John-WL/Hydra-Alpha/prog/documentation/interrupts on Esp32.png

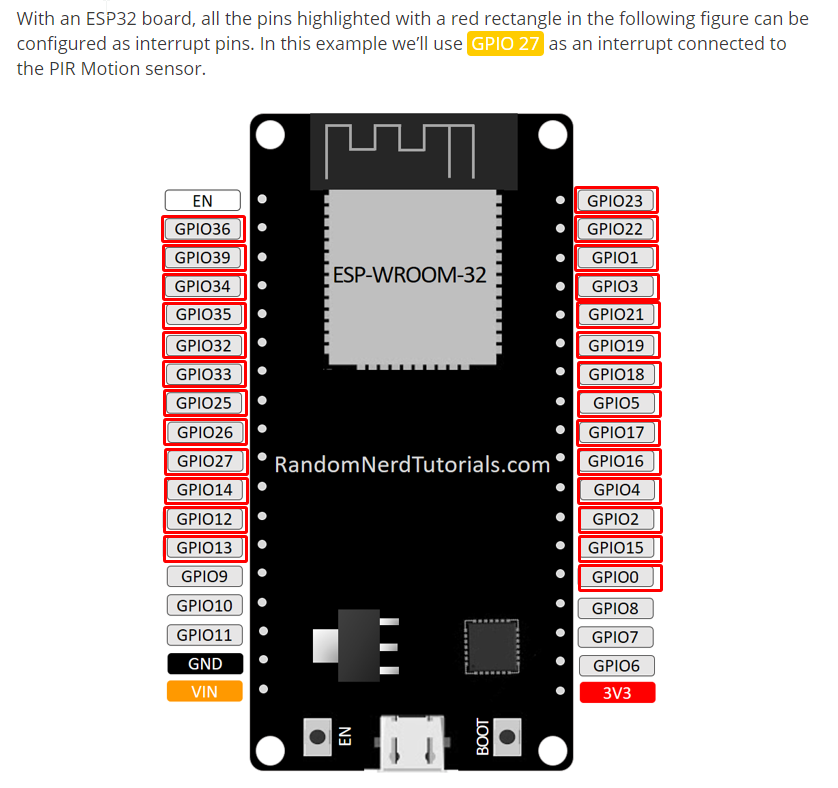
prog/documentation/interrupts on Esp32.png
