John-WL/Hydra-Alpha/board/altium/altium_alpha/Folder Structure - 2021-04-07 11-21-35/BOM/Bill of Materials-PCB_Hydra.xlsx

Comment | Description | Designator | Footprint | LibRef | Quantity
12063C104MAT2A | Capacitor | C1_1, C1_3, C1_4, C2_1, C3_13, C3_15, C4_3, C4_4, C4_7, C4_8, C4_10, C4_11, C4_13 | C1206 | Cap | 13
C1206C103M5RACTU | Capacitor | C1_2, C4_1, C4_2, C4_14, C4_15 | C1206 | Cap | 5
EMK316BJ106MLHT | Capacitor | C1_5, C3_14 | C1206 | Cap | 2
CML1206C0G470JT50V | Capacitor | C1_6, C1_7 | C1206 | Cap | 2
CL31A226KOHNNNE | Capacitor | C1_8, C3_1, C3_2, C3_3 | C1206 | Cap | 4
EMHS250GRA102MKE0S | Capacitor | C2_2, C2_3, C2_4 | CAP-ELECTRO-KE0 | Cap | 3
CML1206X7R472KT50V | Capacitor | C3_4, C3_5, C3_6 | C1206 | Cap | 3
885012208085 | Capacitor | C3_7, C3_8, C3_9 | C1206 | Cap | 3
CM316X5R475K25AT | Capacitor | C3_10, C3_11, C3_18, C3_19 | C1206 | Cap | 4
885382208005 | Capacitor | C3_12, C3_16 | C1206 | Cap | 2
EMK316BBJ476ML-T | Capacitor | C3_17 | C1206 | Cap | 1
C1206C474M5RECAUTO | Capacitor | C4_5 | C1206 | Cap | 1
107AXZ016MQ5 | Capacitor | C4_9, C4_12 | CAP-ELECTRO-530530 | Cap | 2
LTST-C230KRKT | Typical INFRARED GaAs LED | D1_1, D1_2 | C1206-POLARIZED | LED0 | 2
APT3216QBC/D | Typical INFRARED GaAs LED | D1_3, D4_1, D4_2, D4_3, D4_4 | C1206-POLARIZED | LED0 | 5
CZRF52C3V3 | Zener Diode | D3_1, D3_3 | C1206-POLARIZED | D Zener | 2
ACDBN160-HF | Default Diode | D3_4, D3_5 | C1206-POLARIZED | Diode | 2
APT3216SGC | Typical INFRARED GaAs LED | D3_6, D3_7, D3_8 | C1206-POLARIZED | LED0 | 3
MPXV1D0830L3R3 | Inductor | L3_1, L3_2, L3_3 | mpxv1D0830 | Inductor | 3
Mounting Hole | Generic Antenna | M3_1, M3_2, M3_3, M3_4, M3_5 | MOUNTING-HOLE-M3 | Antenna | 5
USB3085-30-A |  | P1_1 | USB-MICRO-CONNECTOR | Usb Connector | 1
Nrf24L01 | Header, 4-Pin, Dual row | P1_2 | HDR2X4-42 | Header 4X2 | 1
EspCam | Header, 4-Pin | P1_3 | HDR1X4-42 | Header 4 | 1
Sonar | Header, 4-Pin | P1_4 | HDR1X4-42 | Header 4 | 1
Header 3 | Header, 3-Pin | P2_1, P2_2, P2_3, P2_4, P2_5, P2_6, P2_7, P2_8, P2_9, P2_10, P2_11, P2_12 | HDR1X3-42 | Header 3 | 12
Bno055 port | Header, 8-Pin | P2_13 | HDR1X8-42 | Header 8 | 1
1521860000 | Header, 2-Pin | P3_1 | HDR1X2-508-POLARIZED | Header 2 | 1
Right Motor Connector | Header, 2-Pin | P4_1 | HDR1X2-42 | Header 2 | 1
Left Motor Connector | Header, 2-Pin | P4_2 | HDR1X2-42 | Header 2 | 1
T2N7002AK,LM | N-Channel MOSFET | Q1_1, Q1_2, Q2_1, Q2_2, Q3_2 | SOT23_L | MOSFET-N | 5
RQ5L015SPTL | P-Channel MOSFET | Q3_1 | SOT23_L | MOSFET-P | 1
Res1 | Resistor | R1_1, R1_2, R1_3, R1_4, R1_5, R1_6, R1_7, R1_8, R1_9, R1_10, R1_11, R1_12, R1_13, R1_14, R2_1, R2_2, R2_3, R2_4, R3_1, R3_2, R3_3, R3_4, R3_5, R3_6, R3_7, R3_8, R3_9, R3_10, R3_11, R3_13, R3_14, R3_15, R3_16, R3_18, R3_19, R3_20, R3_21, R3_22, R3_23, R3_24, R4_1, R4_2, R4_4, R4_5, R4_8, R4_9, R4_10, R4_11, R4_13, R4_14, R4_15 | C1206 | Res1 | 51
ST4ETA103 | Potentiometer | R3_25, R3_26, R3_27 | ST-4ETA103 | RPot | 3
ST32ETB203 | Potentiometer | R4_3 | ST-32EB | RPot | 1
PCS2512DR1000ET | Resistor | R4_6, R4_7 | 2512 | Res1 | 2
Res1 | Resistor | R4_12 | C0805 | Res1 | 1
FSM4LPASTR | Switch | S1_1, S1_2 | SW4-SMT | SW-PB | 2
S1A | Single-Pole, Single-Throw Switch | S3_1 | SW2-THR | SW-SPST | 1
Mounting Hole | Generic Antenna | T1_1, T1_2, T1_3, T1_4, T1_5, T1_6, T3_1, T3_2, T3_3, T3_4, T3_5, T3_6, T3_7, T3_8, T3_9, T3_10, T3_11, T3_12 | TESTPOINT | Antenna | 18
ESP32-WROOM-32__16MB_ | Integrated Circuit | U1_1 | ESP32WROOM32D16MB | ESP32-WROOM-32__16MB_ | 1
FT232RL |  | U1_2 | SOP65P778X200-28N | Ft232 | 1
Pca9685 | Serial pwm led driver | U2_1 | SOP65P640X110-28N | Pca9685 | 1
Xr77103-A1r0 | Dc to dc step down converter | U3_1 | 32-TQFN (4x4) | Xr77103-A1r0 | 1
Mic37252 |  | U3_2 | TO-263 (5) | Mic37252 | 1
TS391SN2T1G |  | U3_3 | TSOP5(6) | Op Amp | 1
Drv8829 |  | U4_1, U4_2 | SOP65P640X120-28N-GROUND_SINK | Drv8829 | 2
Xra1201 |  | U4_3 | SOP65P640X110-24N | Xra1201 | 1
