John-WL/Hydra-Alpha/board/altium/altium_alpha/Project Outputs for PCB_Hydra/BOM/generated from digikey.xlsx

Index | Quantity | Part Number | Manufacturer Part Number | Description | Customer Reference | Available | Backorder | Unit Price | Extended Price CAD
1 | 13 | 478-12813-1-ND | 12063C104MAT2A | CAP CER 0.1UF 25V X7R 1206 |  | 13 | 0 | 0.235 | 3.06
2 | 5 | 399-8138-1-ND | C1206C103M5RACTU | CAP CER 10000PF 50V X7R 1206 |  | 5 | 0 | 0.23 | 1.15
3 | 2 | 587-4882-1-ND | EMK316BJ106MLHT | CAP CER 10UF 16V X5R 1206 |  | 2 | 0 | 0.48 | 0.96
4 | 2 | 738-CML1206C0G470JT50VCT-ND | CML1206C0G470JT50V | CAP CER 47PF 50V C0G/NP0 1206 |  | 2 | 0 | 0.26 | 0.52
5 | 4 | 1276-3048-1-ND | CL31A226KOHNNNE | CAP CER 22UF 16V X5R 1206 |  | 4 | 0 | 0.55 | 2.20
6 | 3 | 565-5087-1-ND | EMHS250GRA102MKE0S | CAP ALUM 1000UF 20% 25V SMD |  | 3 | 0 | 2.03 | 6.09
7 | 3 | 738-CML1206X7R472KT50VCT-ND | CML1206X7R472KT50V | CAP CER 4700PF 50V X7R 1206 |  | 3 | 0 | 0.27 | 0.81
8 | 3 | 732-8125-1-ND | 885012208085 | CAP CER 0.047UF 50V X7R 1206 |  | 3 | 0 | 0.18 | 0.54
9 | 4 | 1253-2080-1-ND | CM316X5R475K25AT | CAP CER 4.7UF 25V X5R 1206 |  | 4 | 0 | 0.49 | 1.96
10 | 2 | 732-13203-1-ND | 885382208005 | CAP CER 1UF 50V X7R 1206 |  | 2 | 0 | 0.37 | 0.74
11 | 1 | 587-5425-1-ND | EMK316BBJ476ML-T | CAP CER 47UF 16V X5R 1206 |  | 1 | 0 | 1 | 1.00
12 | 1 | 399-C1206C474M5RECAUTOCT-ND | C1206C474M5RECAUTO | CAP CER 1206 470NF 50V X7R 20% |  | 1 | 0 | 0.55 | 0.55
13 | 2 | 1572-1239-1-ND | 107AXZ016MQ5 | CAP ALUM 100UF 20% 16V SMD |  | 2 | 0 | 0.64 | 1.28
14 | 2 | 160-1457-1-ND | LTST-C230KRKT | LED RED CLEAR CHIP SMD |  | 2 | 0 | 0.42 | 0.84
15 | 5 | 754-1439-1-ND | APT3216QBC/D | LED BLUE CLEAR CHIP SMD |  | 5 | 0 | 0.66 | 3.30
16 | 2 | 641-1056-1-ND | CZRF52C3V3 | DIODE ZENER 3.3V 200MW 1005 |  | 2 | 0 | 0.56 | 1.12
17 | 2 | 641-1616-1-ND | ACDBN160-HF | DIODE SCHOTTKY 60V 1A 1206 |  | 2 | 0 | 0.53 | 1.06
18 | 3 | 754-1141-1-ND | APT3216SGC | LED GREEN CLEAR CHIP SMD |  | 3 | 0 | 0.42 | 1.26
19 | 3 | 399-MPXV1D0830L3R3CT-ND | MPXV1D0830L3R3 | FIXED IND 3.3UH 8.9A 22.3 MOHM |  | 3 | 0 | 3.22 | 9.66
20 | 1 | 2073-USB3085-30-ACT-ND | USB3085-30-A | MICRO A/B SKT, BOTTOM-SMT, R/A, |  | 1 | 0 | 0.91 | 0.91
21 | 5 | T2N7002AKLMCT-ND | T2N7002AK,LM | MOSFET N-CH 60V 200MA SOT23 |  | 5 | 0 | 0.22 | 1.10
22 | 1 | RQ5L015SPTLCT-ND | RQ5L015SPTL | MOSFET P-CH 60V 1.5A TSMT3 |  | 1 | 0 | 0.6 | 0.60
23 | 3 | ST4ETA103CT-ND | ST4ETA103 | TRIMMER 10K OHM 0.25W J LEAD TOP |  | 3 | 0 | 1.74 | 5.22
24 | 1 | ST32ETB203CT-ND | ST32ETB203 | TRIMMER 20K OHM 0.125W GW TOP |  | 1 | 0 | 1.89 | 1.89
25 | 2 | 450-2139-1-ND | FSM4LPASTR | SWITCH TACTILE SPST-NO 0.05A 24V |  | 2 | 0 | 0.74 | 1.48
26 | 1 | 360-2893-ND | S1A | SWITCH TOGGLE SPST 15A 125V |  | 1 | 0 | 8.51 | 8.51
27 | 1 | 1904-1028-1-ND | ESP32-WROOM-32U (16MB) | RX TXRX MODULE WIFI U.FL SMD |  | 1 | 0 | 6.76 | 6.76
28 | 1 | 768-1007-1-ND | FT232RL-REEL | IC USB FS SERIAL UART 28-SSOP |  | 1 | 0 | 6.69 | 6.69
29 | 1 | 568-8366-5-ND | PCA9685PW,112 | IC LED DRVR LIN DIM 25MA 28TSSOP |  | 1 | 0 | 3.81 | 3.81
30 | 1 | 1016-2216-1-ND | XR77103ELBTR-A1R0 | IC REG BUCK ADJ/FIX TRPL 32TQFN |  | 1 | 0 | 5.21 | 5.21
31 | 1 | 576-1764-5-ND | MIC37252WU | IC REG LIN POS ADJ 2.5A TO263-5 |  | 1 | 0 | 3.61 | 3.61
32 | 1 | TS391SN2T1GOSCT-ND | TS391SN2T1G | IC COMPARATOR LOW PWR 5-TSOP |  | 1 | 0 | 0.9 | 0.90
33 | 2 | 296-28829-1-ND | DRV8829PWPR | IC MTR DRVR BIPLR 8.2-45V 28SSOP |  | 2 | 0 | 5.92 | 11.84
