John-WL/Hydra-Alpha/board/altium/altium_alpha/downloaded libs/drv8829/LIB_DRV8829PWP/DRV8829PWP/3D/DRV8829PWP.stp

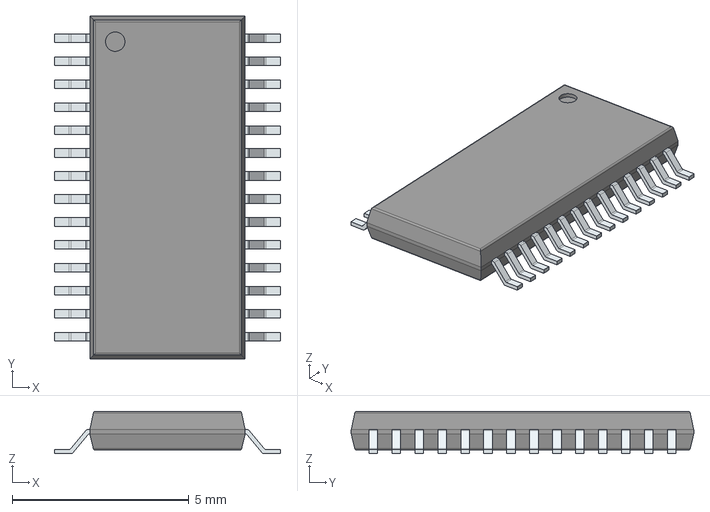
[picture p10: CAD file, 2021-04-13]
board/altium/altium_alpha/downloaded libs/drv8829/LIB_DRV8829PWP/DRV8829PWP/3D/DRV8829PWP.stp
6.40 x 9.70 x 1.20 mm
PinsArrayLR
