John-WL/Hydra-Alpha/board/altium/altium_alpha/downloaded libs/esp32/LIB_ESP32-WROOM-32__16MB_/ESP32-WROOM-32__16MB_/3D/ESP32-WROOM-32__16MB_.stp

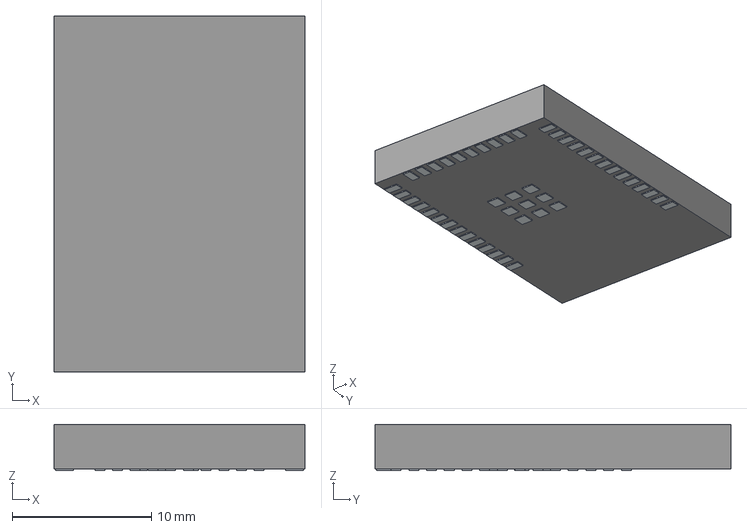
[picture p11: CAD file, 2021-04-13]
board/altium/altium_alpha/downloaded libs/esp32/LIB_ESP32-WROOM-32__16MB_/ESP32-WROOM-32__16MB_/3D/ESP32-WROOM-32__16MB_.stp
18.0 x 25.5 x 3.30 mm
Pins
