John-WL/Hydra-Alpha/board/altium/altium_alpha/downloaded libs/ft232r/LIB_FT232RL/FT232RL/3D/FT232RL.stp

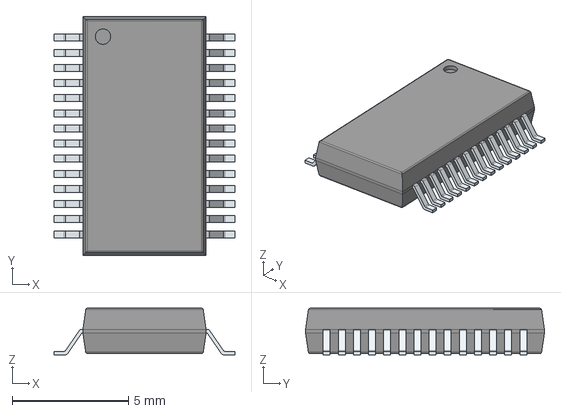
[picture p12: CAD file, 2021-04-13]
board/altium/altium_alpha/downloaded libs/ft232r/LIB_FT232RL/FT232RL/3D/FT232RL.stp
7.78 x 10.3 x 2.00 mm
PinsArrayLR
