John-WL/Hydra-Alpha/board/altium/altium_alpha/downloaded libs/pca9685/LIB_PCA9685PW,112/PCA9685PW,112/3D/PCA9685PW,112.stp

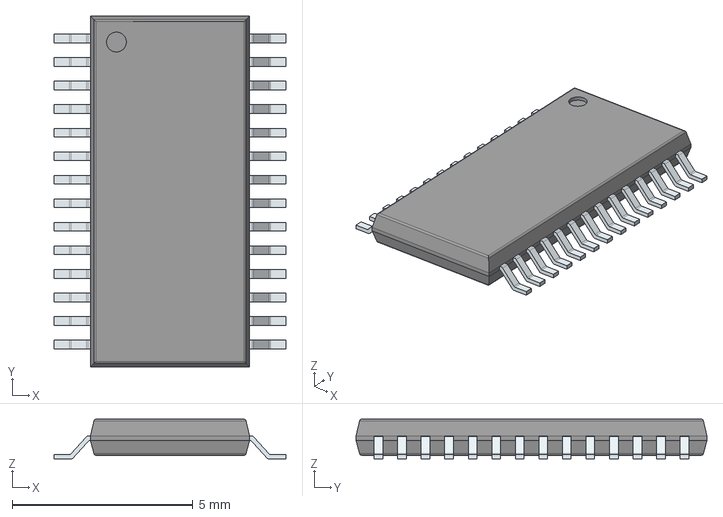
[picture p13: CAD file, 2021-04-13]
board/altium/altium_alpha/downloaded libs/pca9685/LIB_PCA9685PW,112/PCA9685PW,112/3D/PCA9685PW,112.stp
6.40 x 9.70 x 1.10 mm
PinsArrayLR
