John-WL/Hydra-Alpha/board/altium/altium_alpha/downloaded libs/xra1201/LIB_PCA9539PW,118/PCA9539PW,118/3D/PCA9539PW,118.stp

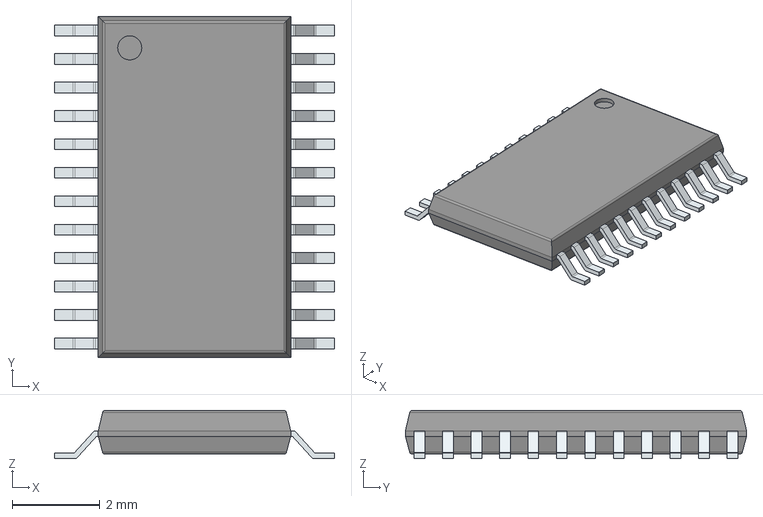
[picture p14: CAD file, 2021-04-13]
board/altium/altium_alpha/downloaded libs/xra1201/LIB_PCA9539PW,118/PCA9539PW,118/3D/PCA9539PW,118.stp
6.40 x 7.80 x 1.10 mm
PinsArrayLR
