John-WL/Hydra-Alpha/board/altium/altium_alpha/Folder Structure - 2021-04-07 11-21-35/ExportSTEP/PCB_Alpha.step

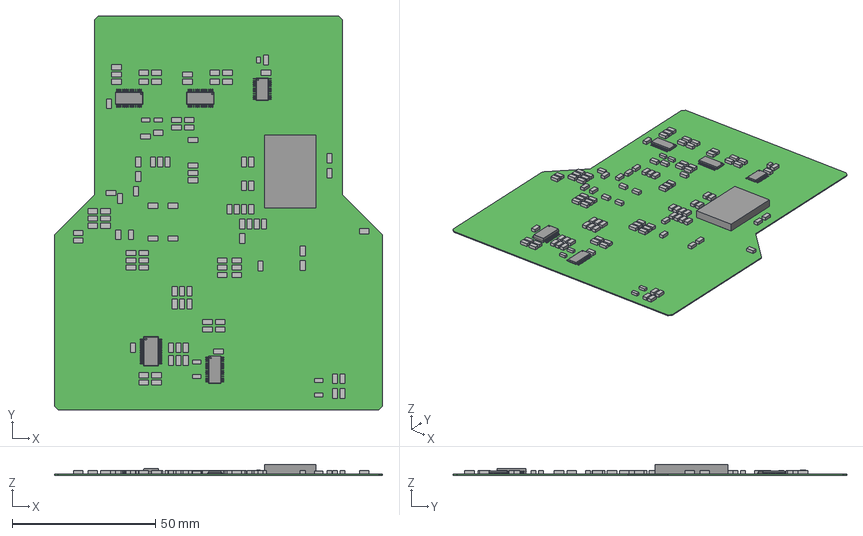
[picture p15: CAD file, 2021-04-13]
board/altium/altium_alpha/Folder Structure - 2021-04-07 11-21-35/ExportSTEP/PCB_Alpha.step
114.3 x 137.2 x 3.71 mm
PinsArrayLR x 5
Extruded x 112
Pins
