John-WL/Hydra-Alpha/(list of files, cad)

Other CAD files:
board/altium/altium_alpha/Project Outputs for Free Documents/ExportSTEP/PCB_Alpha.step
board/altium/altium_alpha/Project Outputs for PCB_Hydra/ExportSTEP/PCB_Alpha.step
board/altium/altium_alpha/downloaded libs/drv8829/LIB_DRV8829PWP/DRV8829PWP/3D/DRV8829PWP.stl
board/altium/altium_alpha/downloaded libs/drv8829/LIB_DRV8829PWP/DRV8829PWP/Allegro/sop65p640x120-28n.psm
board/altium/altium_alpha/downloaded libs/drv8829/LIB_DRV8829PWP/DRV8829PWP/DEHDL/drv8829pwp/chips/chips.prt
board/altium/altium_alpha/downloaded libs/esp32/LIB_ESP32-WROOM-32__16MB_/ESP32-WROOM-32__16MB_/3D/ESP32-WROOM-32__16MB_.stl
board/altium/altium_alpha/downloaded libs/esp32/LIB_ESP32-WROOM-32__16MB_/ESP32-WROOM-32__16MB_/Allegro/esp32wroom3216mb.psm
board/altium/altium_alpha/downloaded libs/esp32/LIB_ESP32-WROOM-32__16MB_/ESP32-WROOM-32__16MB_/DEHDL/esp32_wroom_32__16mb_/chips/chips.prt
board/altium/altium_alpha/downloaded libs/ft232r/LIB_FT232RL/FT232RL/3D/FT232RL.stl
board/altium/altium_alpha/downloaded libs/ft232r/LIB_FT232RL/FT232RL/Allegro/sop65p778x200-28n.psm
board/altium/altium_alpha/downloaded libs/ft232r/LIB_FT232RL/FT232RL/DEHDL/ft232rl/chips/chips.prt
board/altium/altium_alpha/downloaded libs/pca9685/LIB_PCA9685PW,112/PCA9685PW,112/3D/PCA9685PW,112.stl
board/altium/altium_alpha/downloaded libs/pca9685/LIB_PCA9685PW,112/PCA9685PW,112/Allegro/sop65p640x110-28n.psm
board/altium/altium_alpha/downloaded libs/pca9685/LIB_PCA9685PW,112/PCA9685PW,112/DEHDL/pca9685pw_112/chips/chips.prt
board/altium/altium_alpha/downloaded libs/xra1201/LIB_PCA9539PW,118/PCA9539PW,118/3D/PCA9539PW,118.stl
board/altium/altium_alpha/downloaded libs/xra1201/LIB_PCA9539PW,118/PCA9539PW,118/Allegro/sop65p640x110-24n.psm
board/altium/altium_alpha/downloaded libs/xra1201/LIB_PCA9539PW,118/PCA9539PW,118/DEHDL/pca9539pw_118/chips/chips.prt
