John-WL/Hydra-Alpha/board/parts/Omnimate5.08mm Pitch.pdf

Pin headers SL 5.08/135B | Pin headers SL 5.08/180 | Pin headers SL 5.08/180B

# Omnimate Range - 5.08 mm Pitch

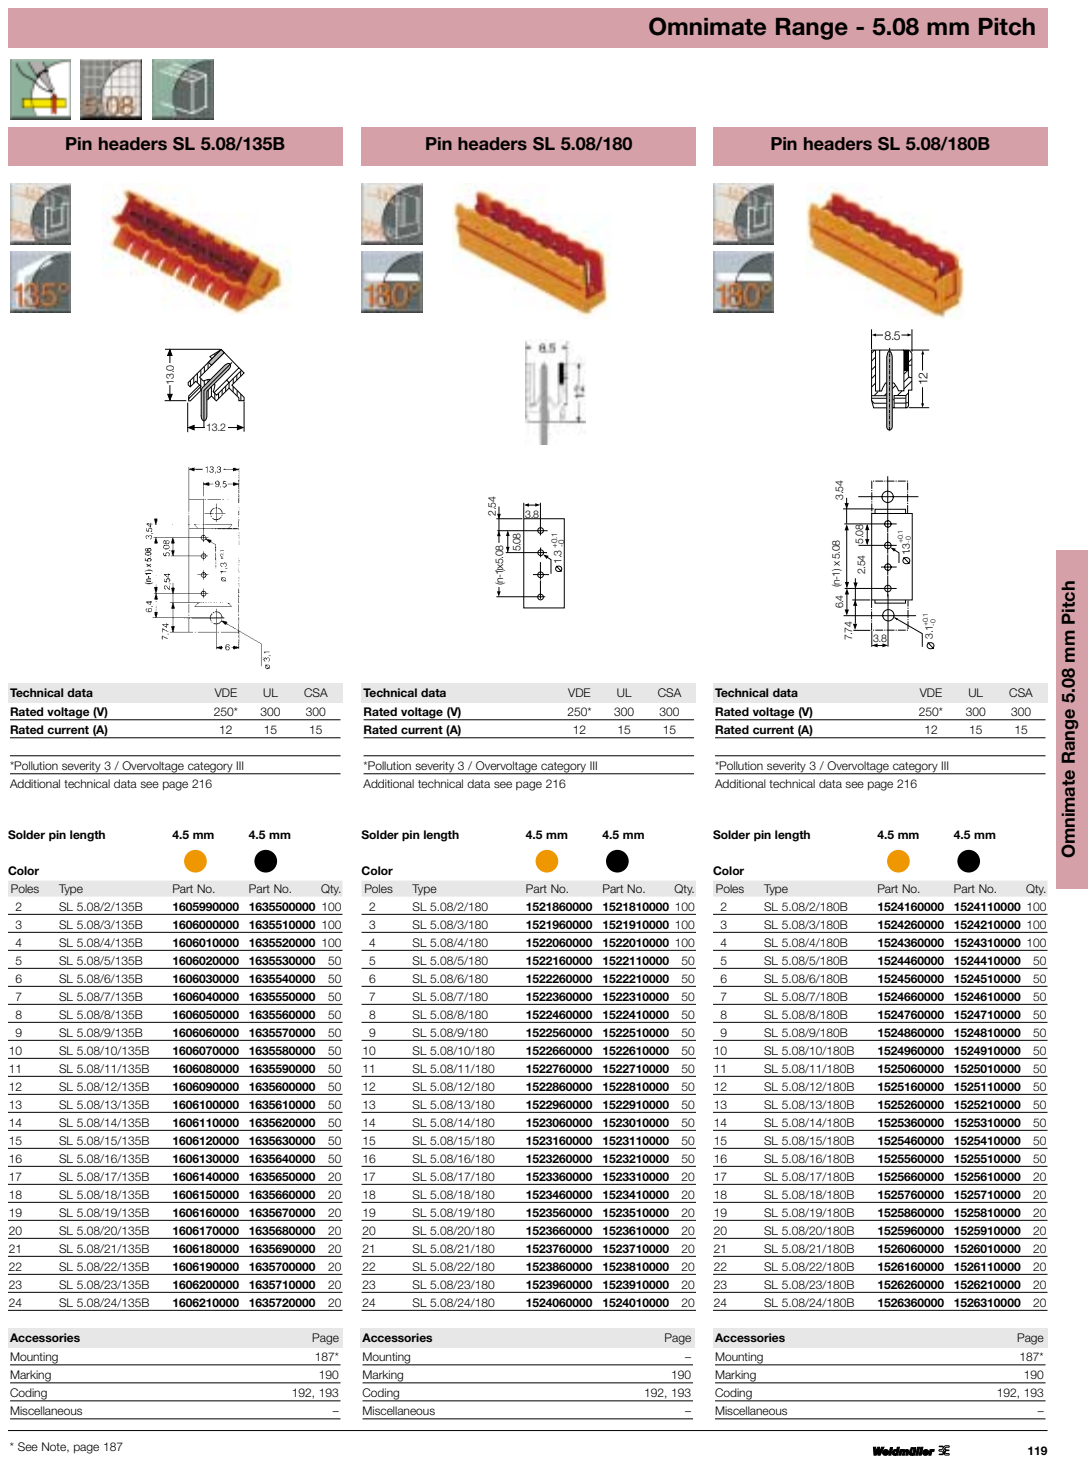
[picture p16: page 1]
Solder pin length; Color; Poles; Type; Part No.; Qty.; Technical data; VDE; CSA; Rated voltage (V); Rated current (A); Accessories; Page; Mounting; Marking; Coding; Miscellaneous

Omnimate Range 5.08 mm Pitch

*Pollution severity 3 / Overvoltage category III
Additional technical data see page 216

* See Note, page 187
