John-WL/Hydra-Alpha/board/altium/altium_alpha/PDF - 2021-04-06 14-30-56/Job1.PDF

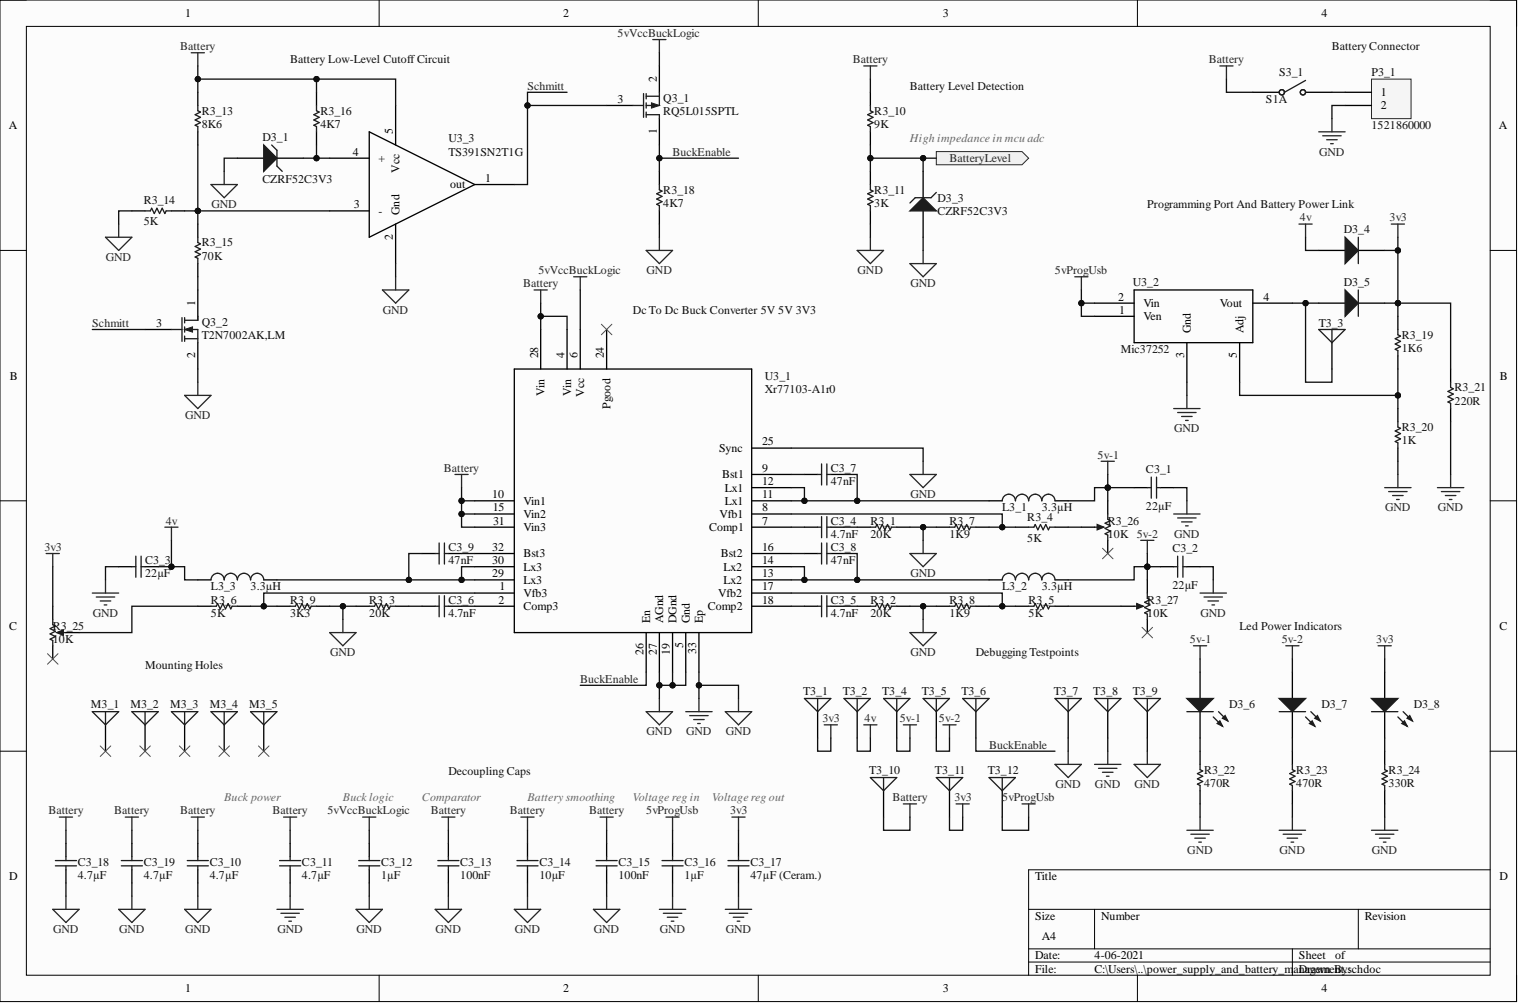
[picture p17: page 1]

Battery Low-Level Cutoff Circuit

High impedance in mcu adc

Programming Port And Battery Power Link

Dc To Dc Buck Converter 5V 5V 3V3

Vin3 31 Vin2 15 Vin1 10

Ep 33 Gnd 5 DGnd 19 AGnd 27 En 26

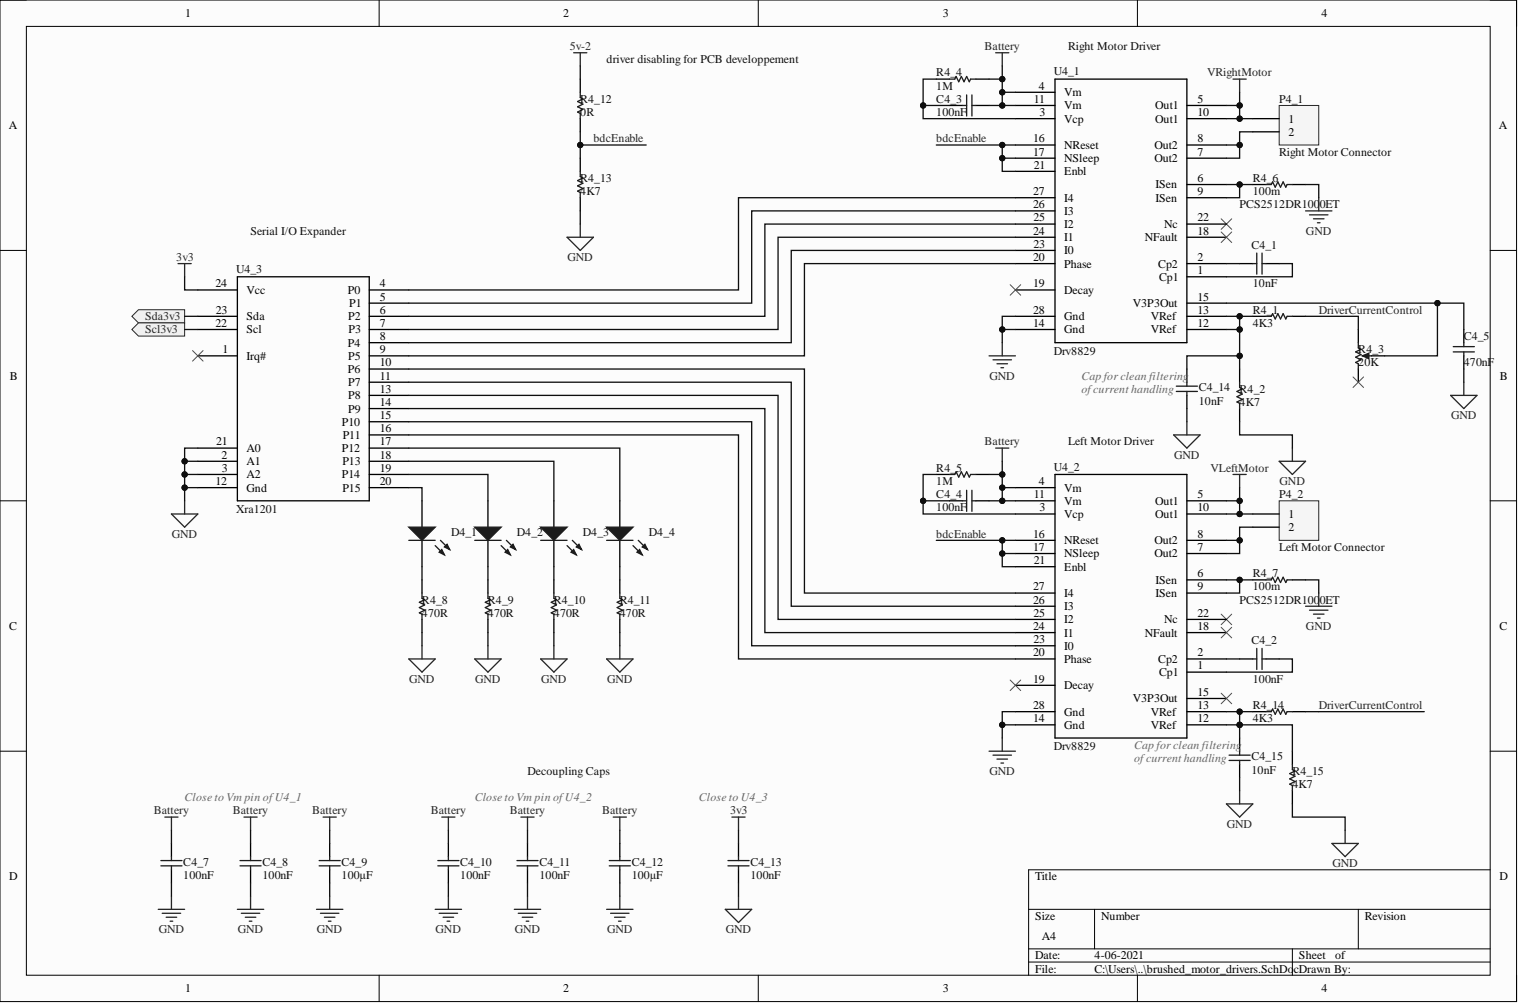
[picture p18: page 2]

driver disabling for PCB developpement

GND | Phase 20

Decay 19

Cap for clean filtering
of current handling

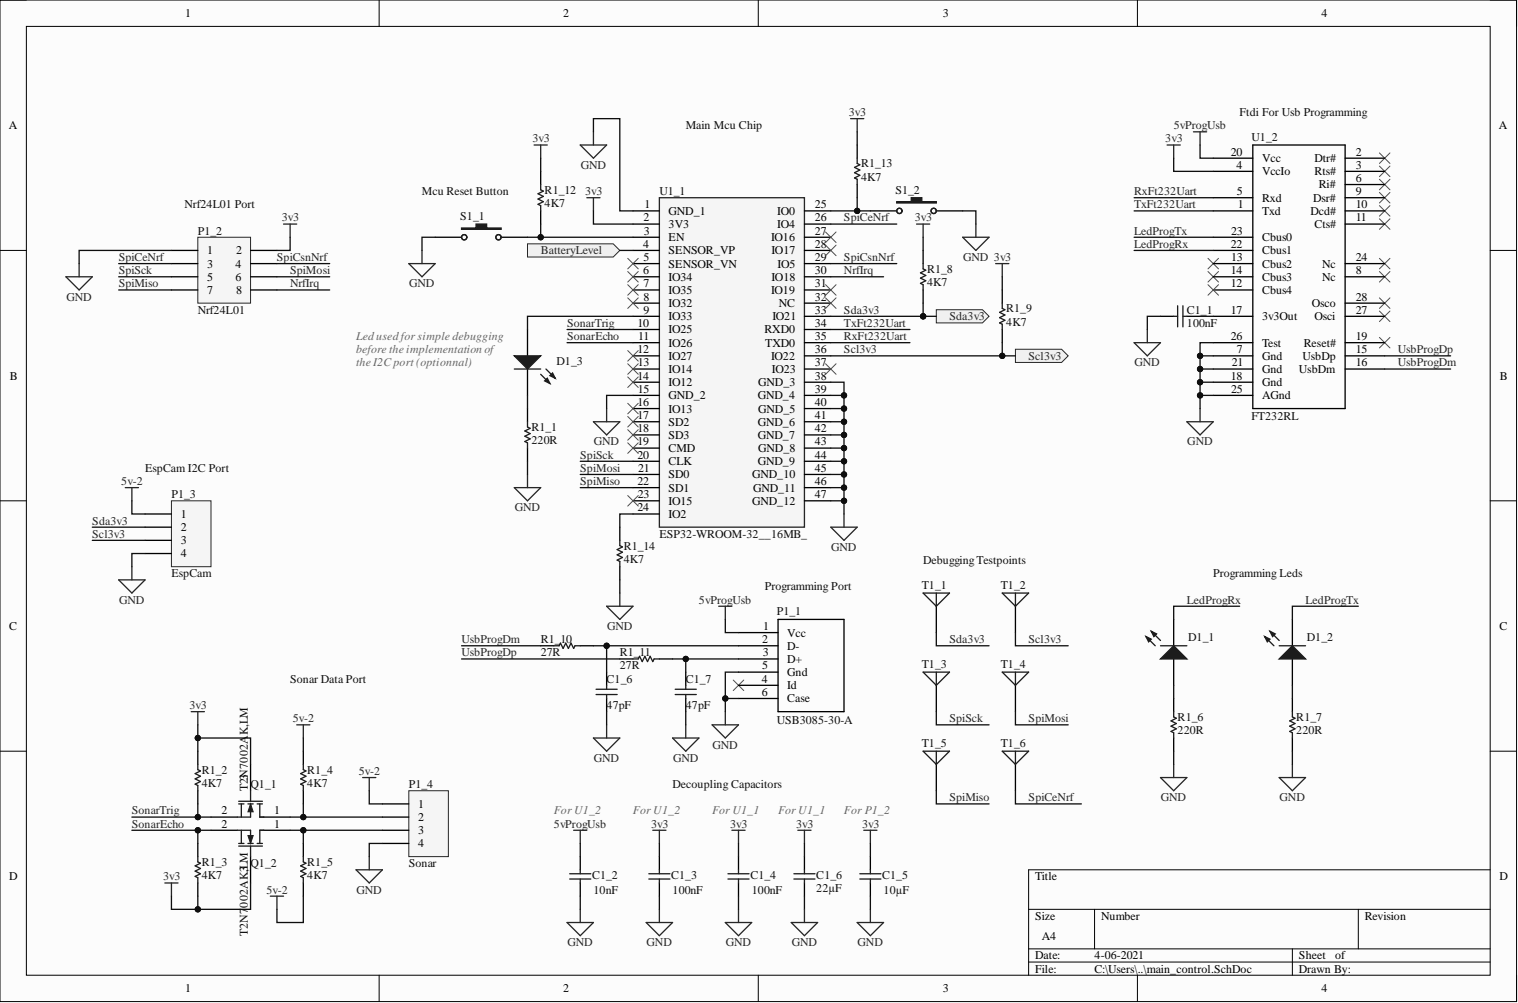
[picture p19: page 3]

Ftdi For Usb Programming

Led used for simple debugging
before the implementation of
the I2C port (optionnal)

Case 6 Id 4

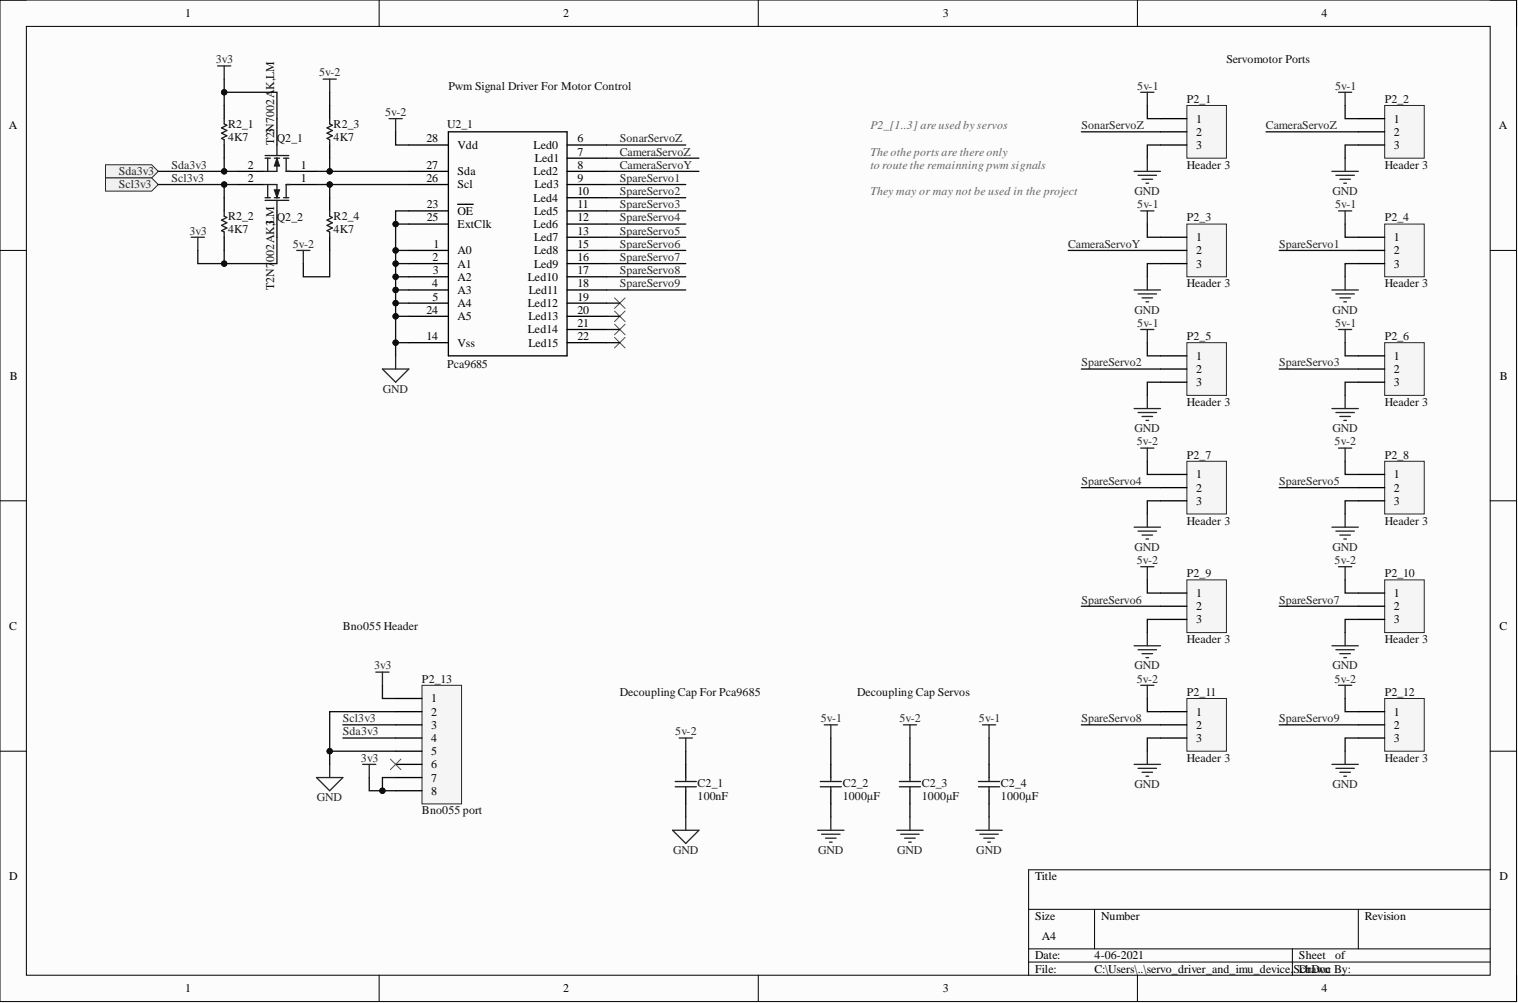
[picture p20: page 4]

Pwm Signal Driver For Motor Control

P2_[1..3] are used by servos

The othe ports are there only
to route the remainning pwm signals

They may or may not be used in the project

A3 4 | SpareServo9
A4 5
A5 24

Scl3v3 Sda3v3

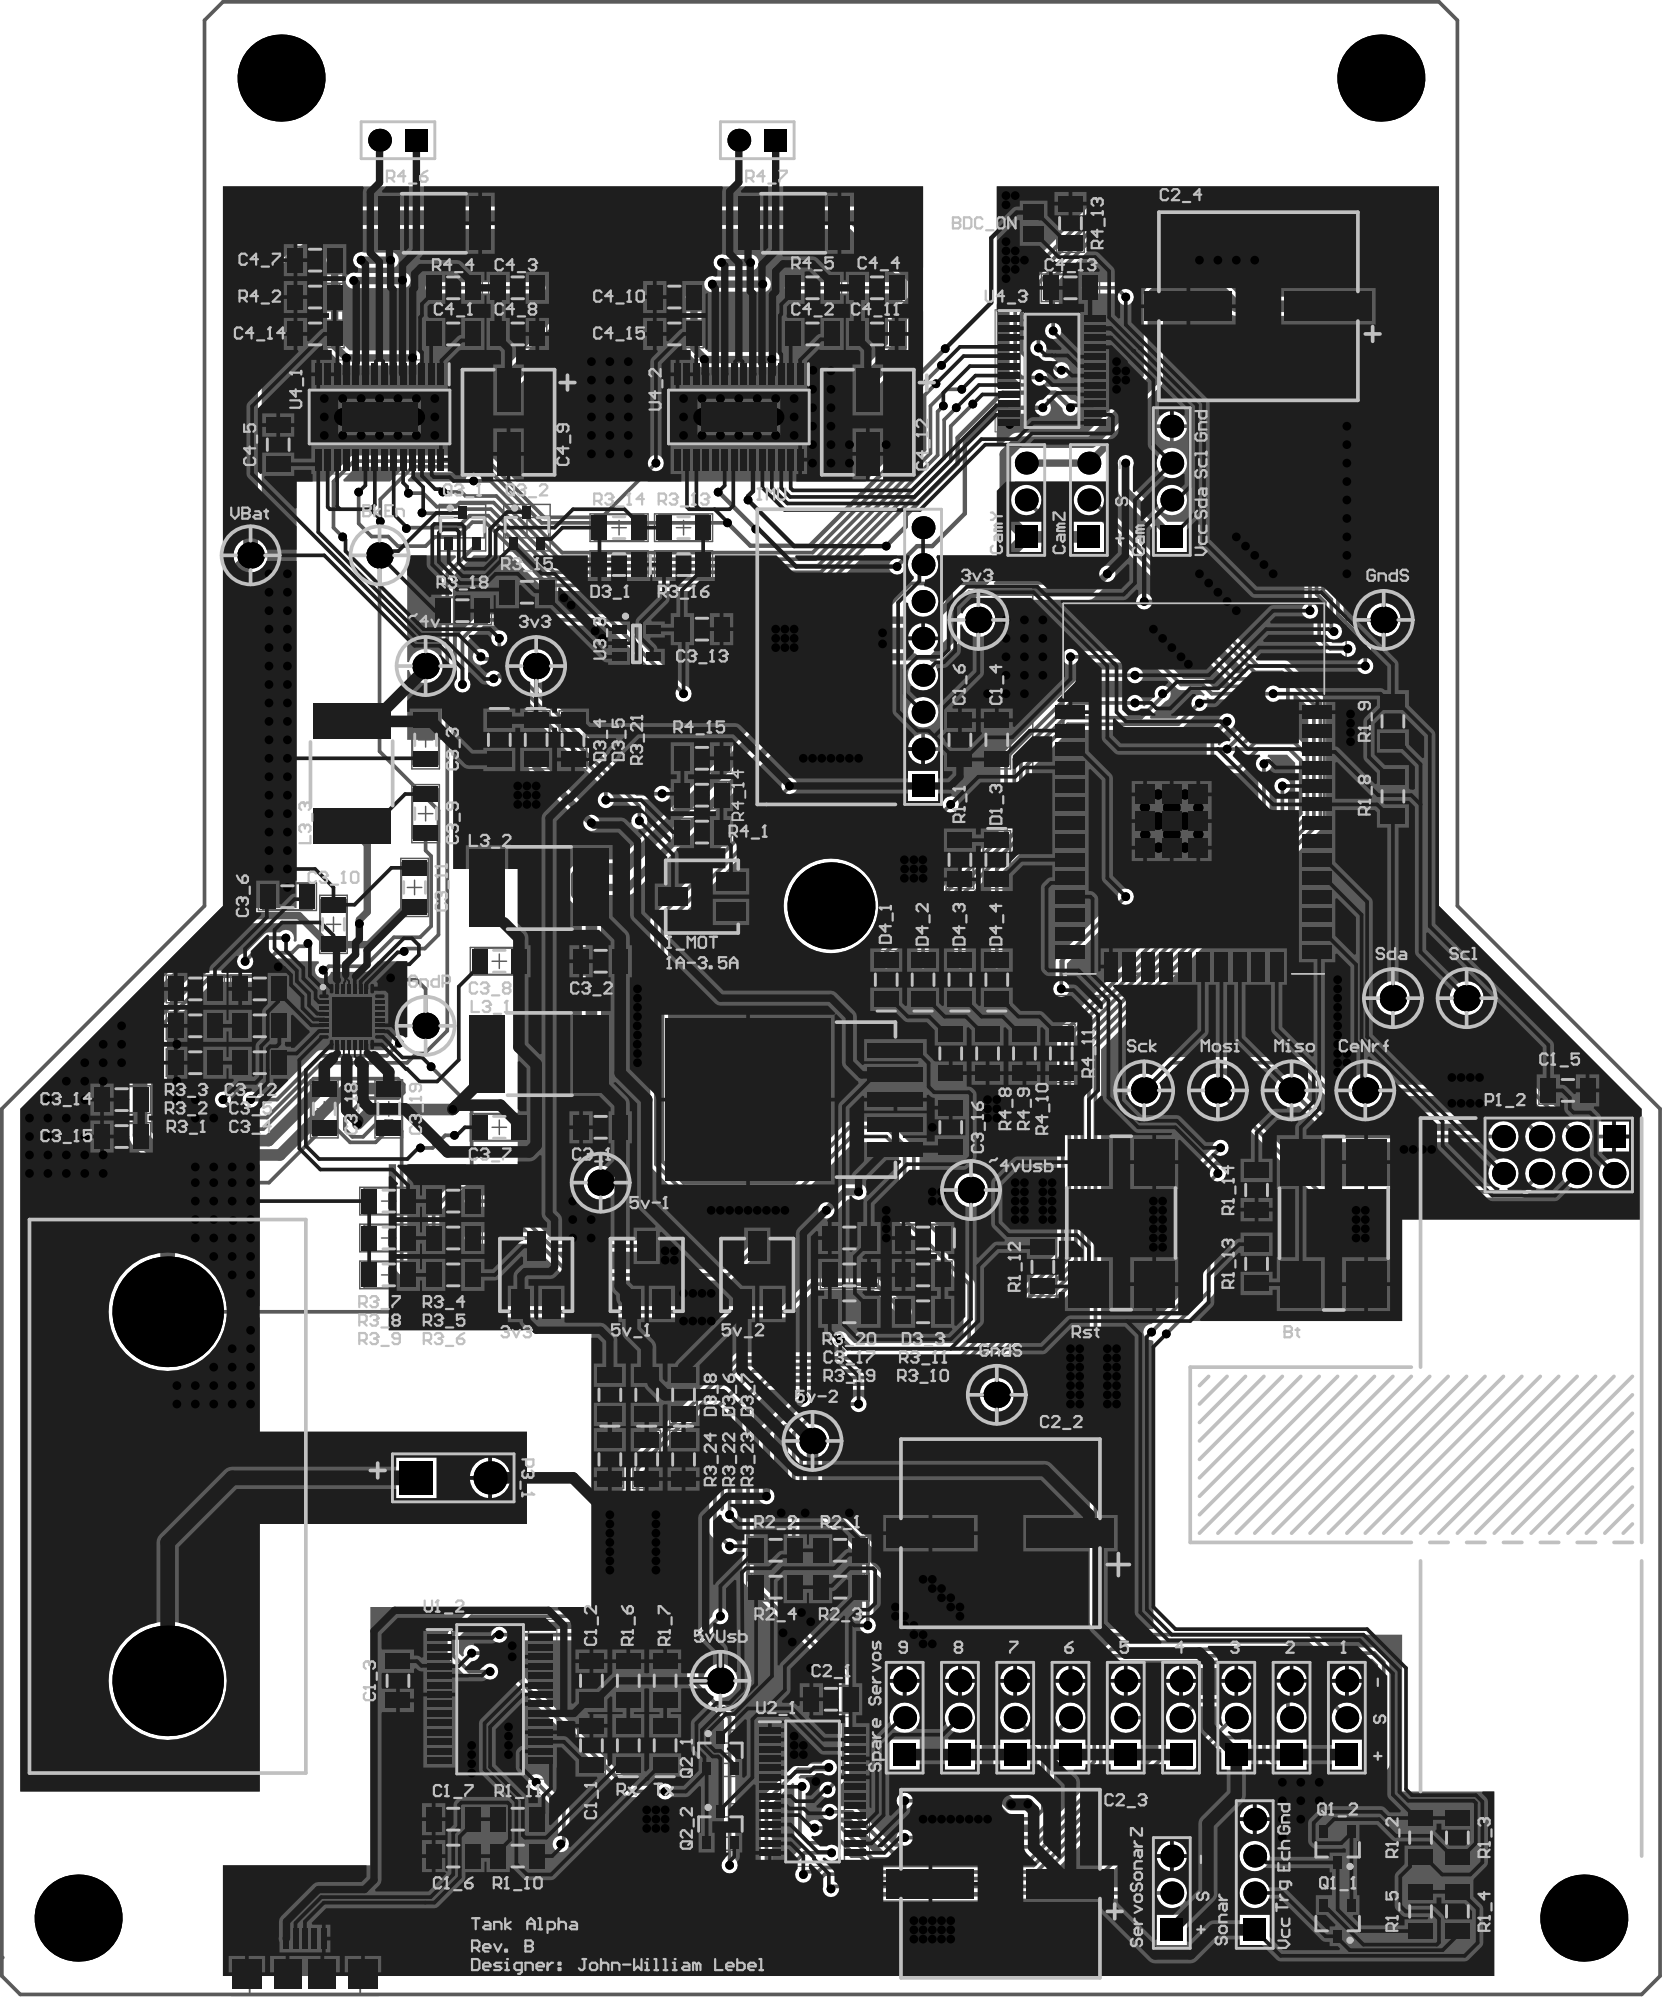
[picture p21: page 5]

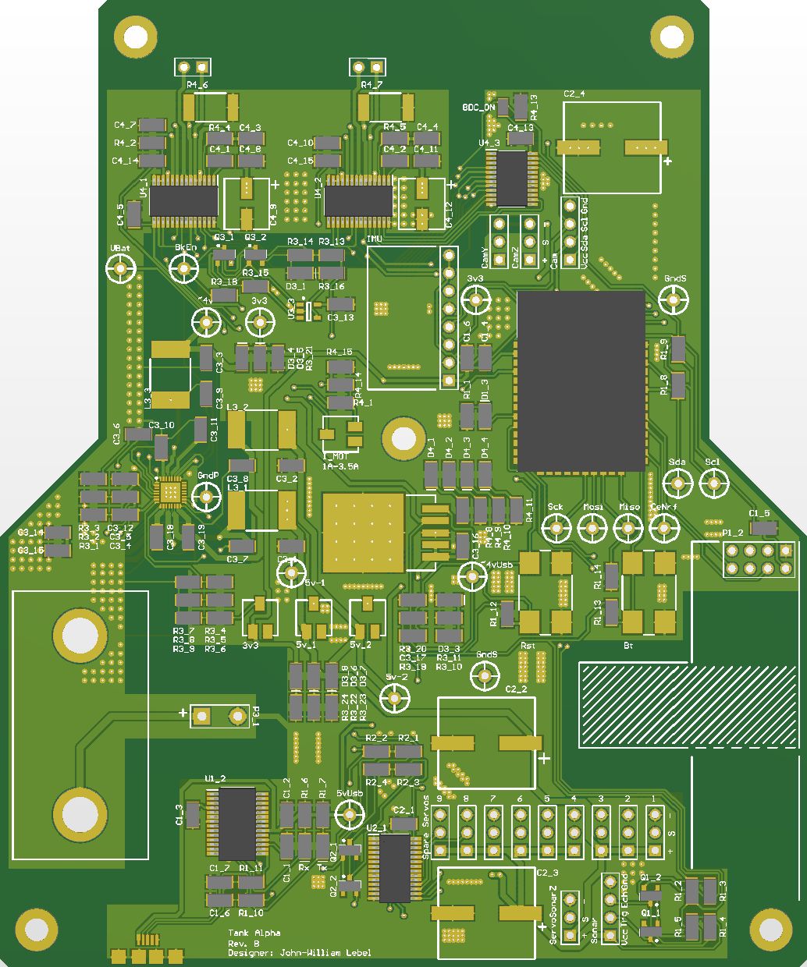
[picture p22: page 6]

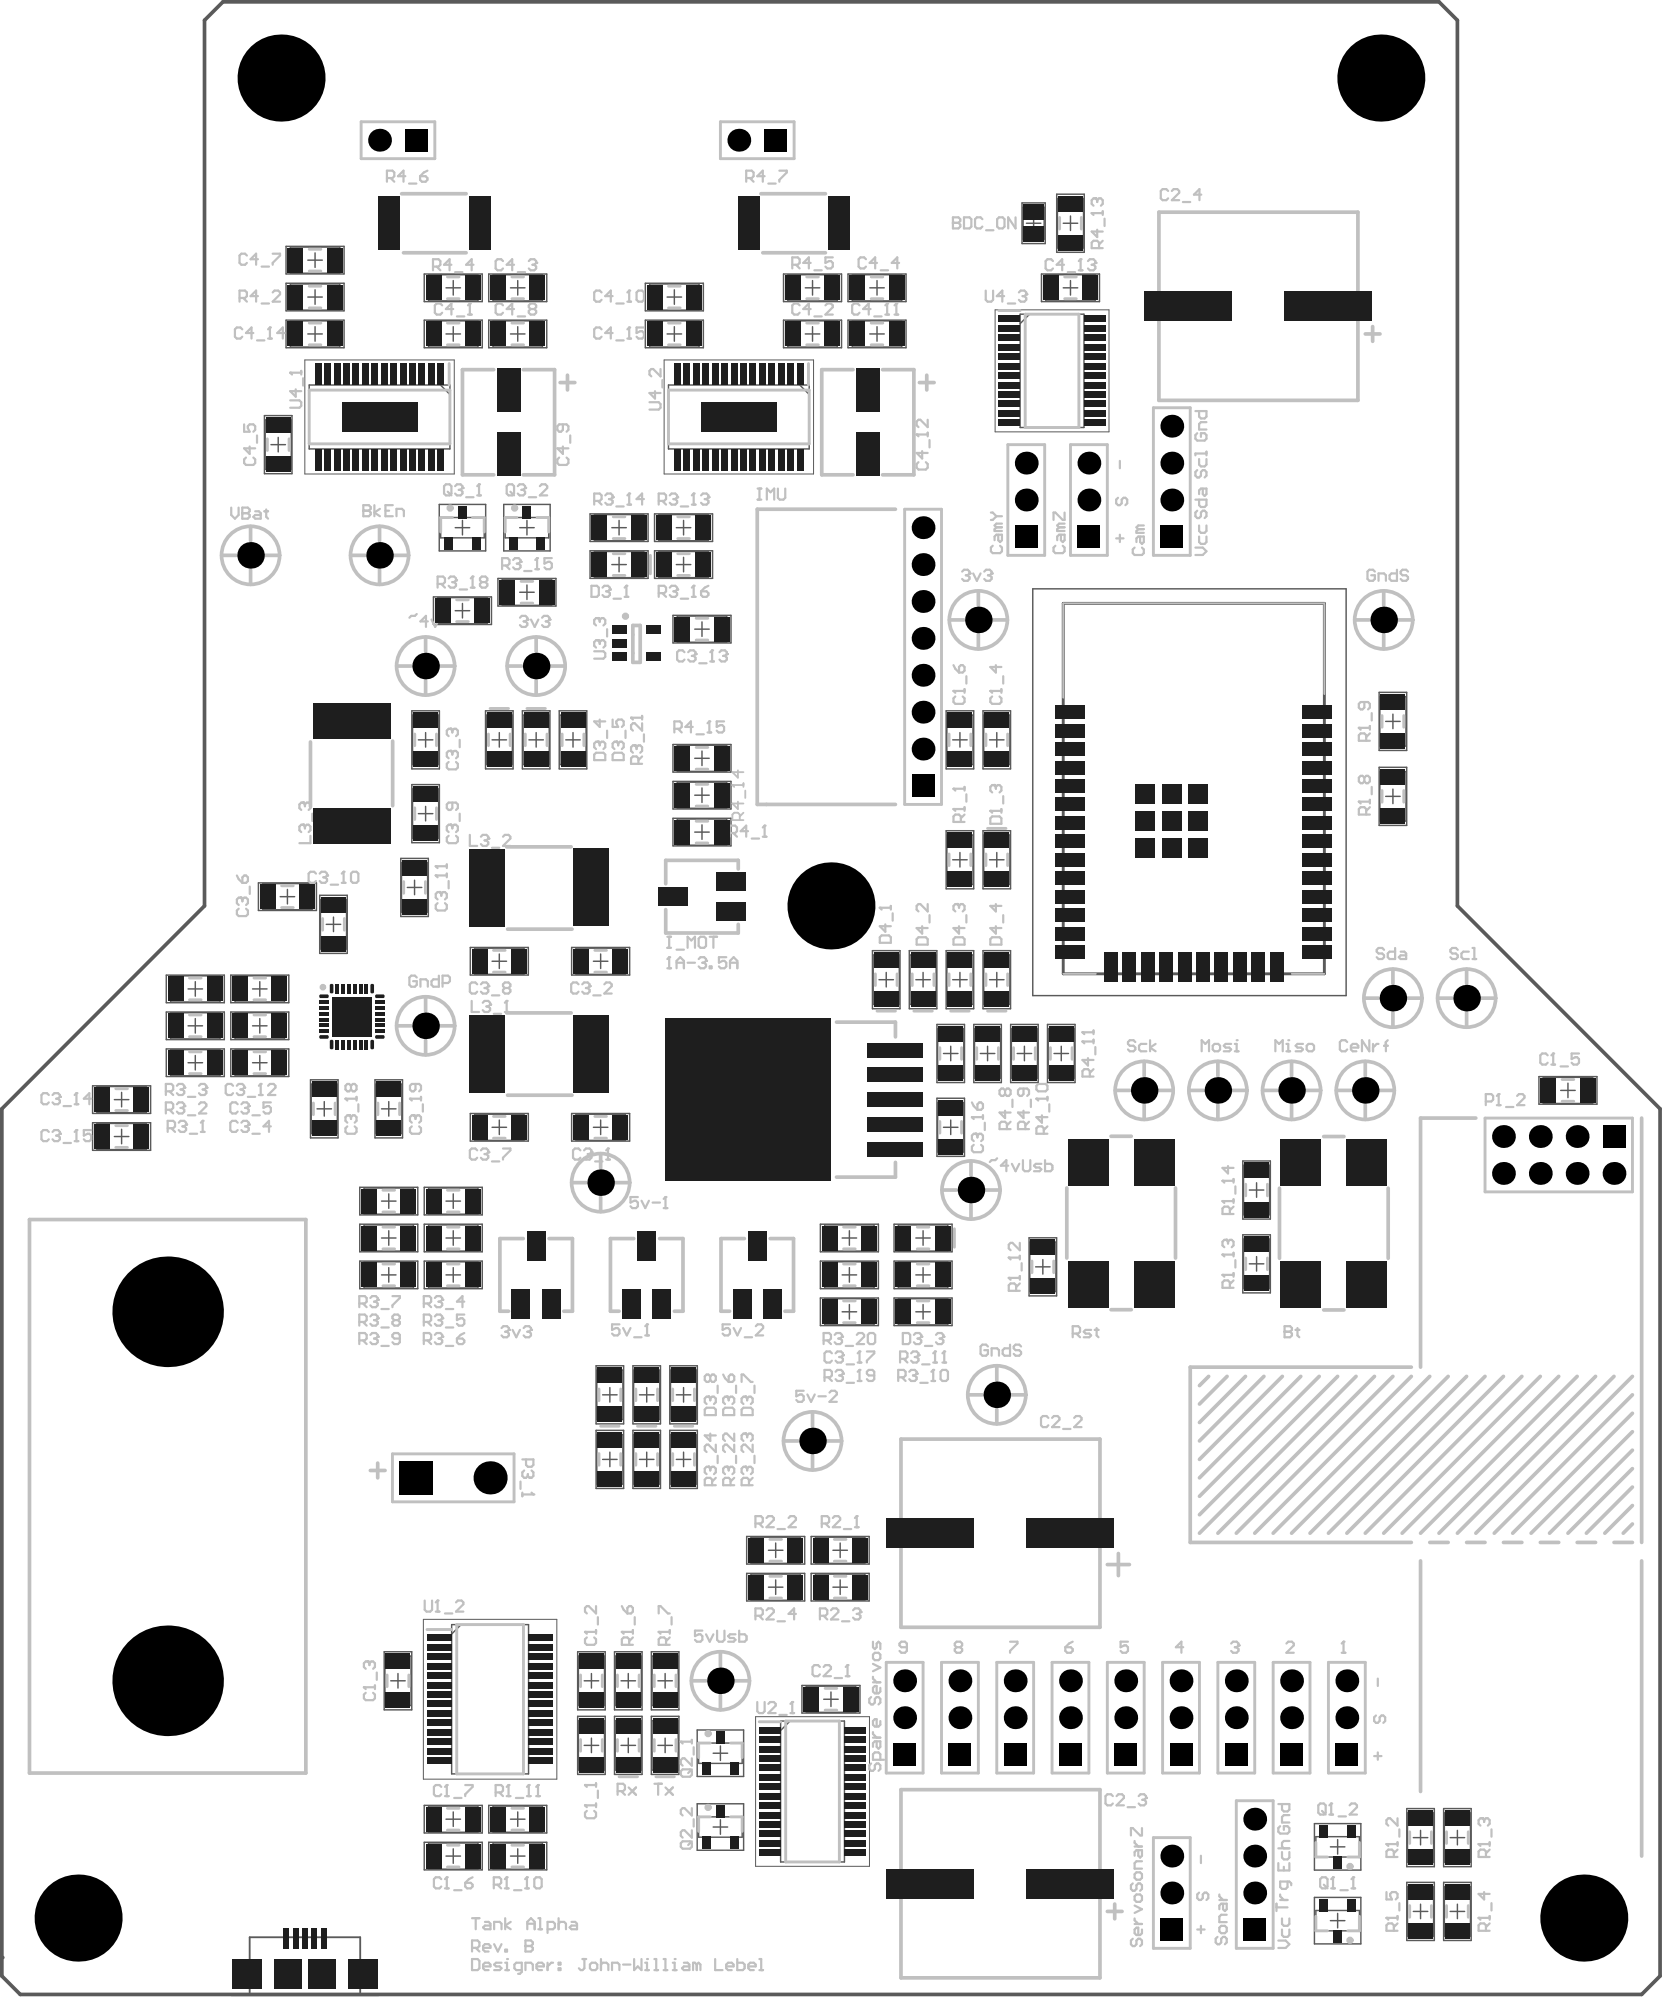
[picture p23: page 7]

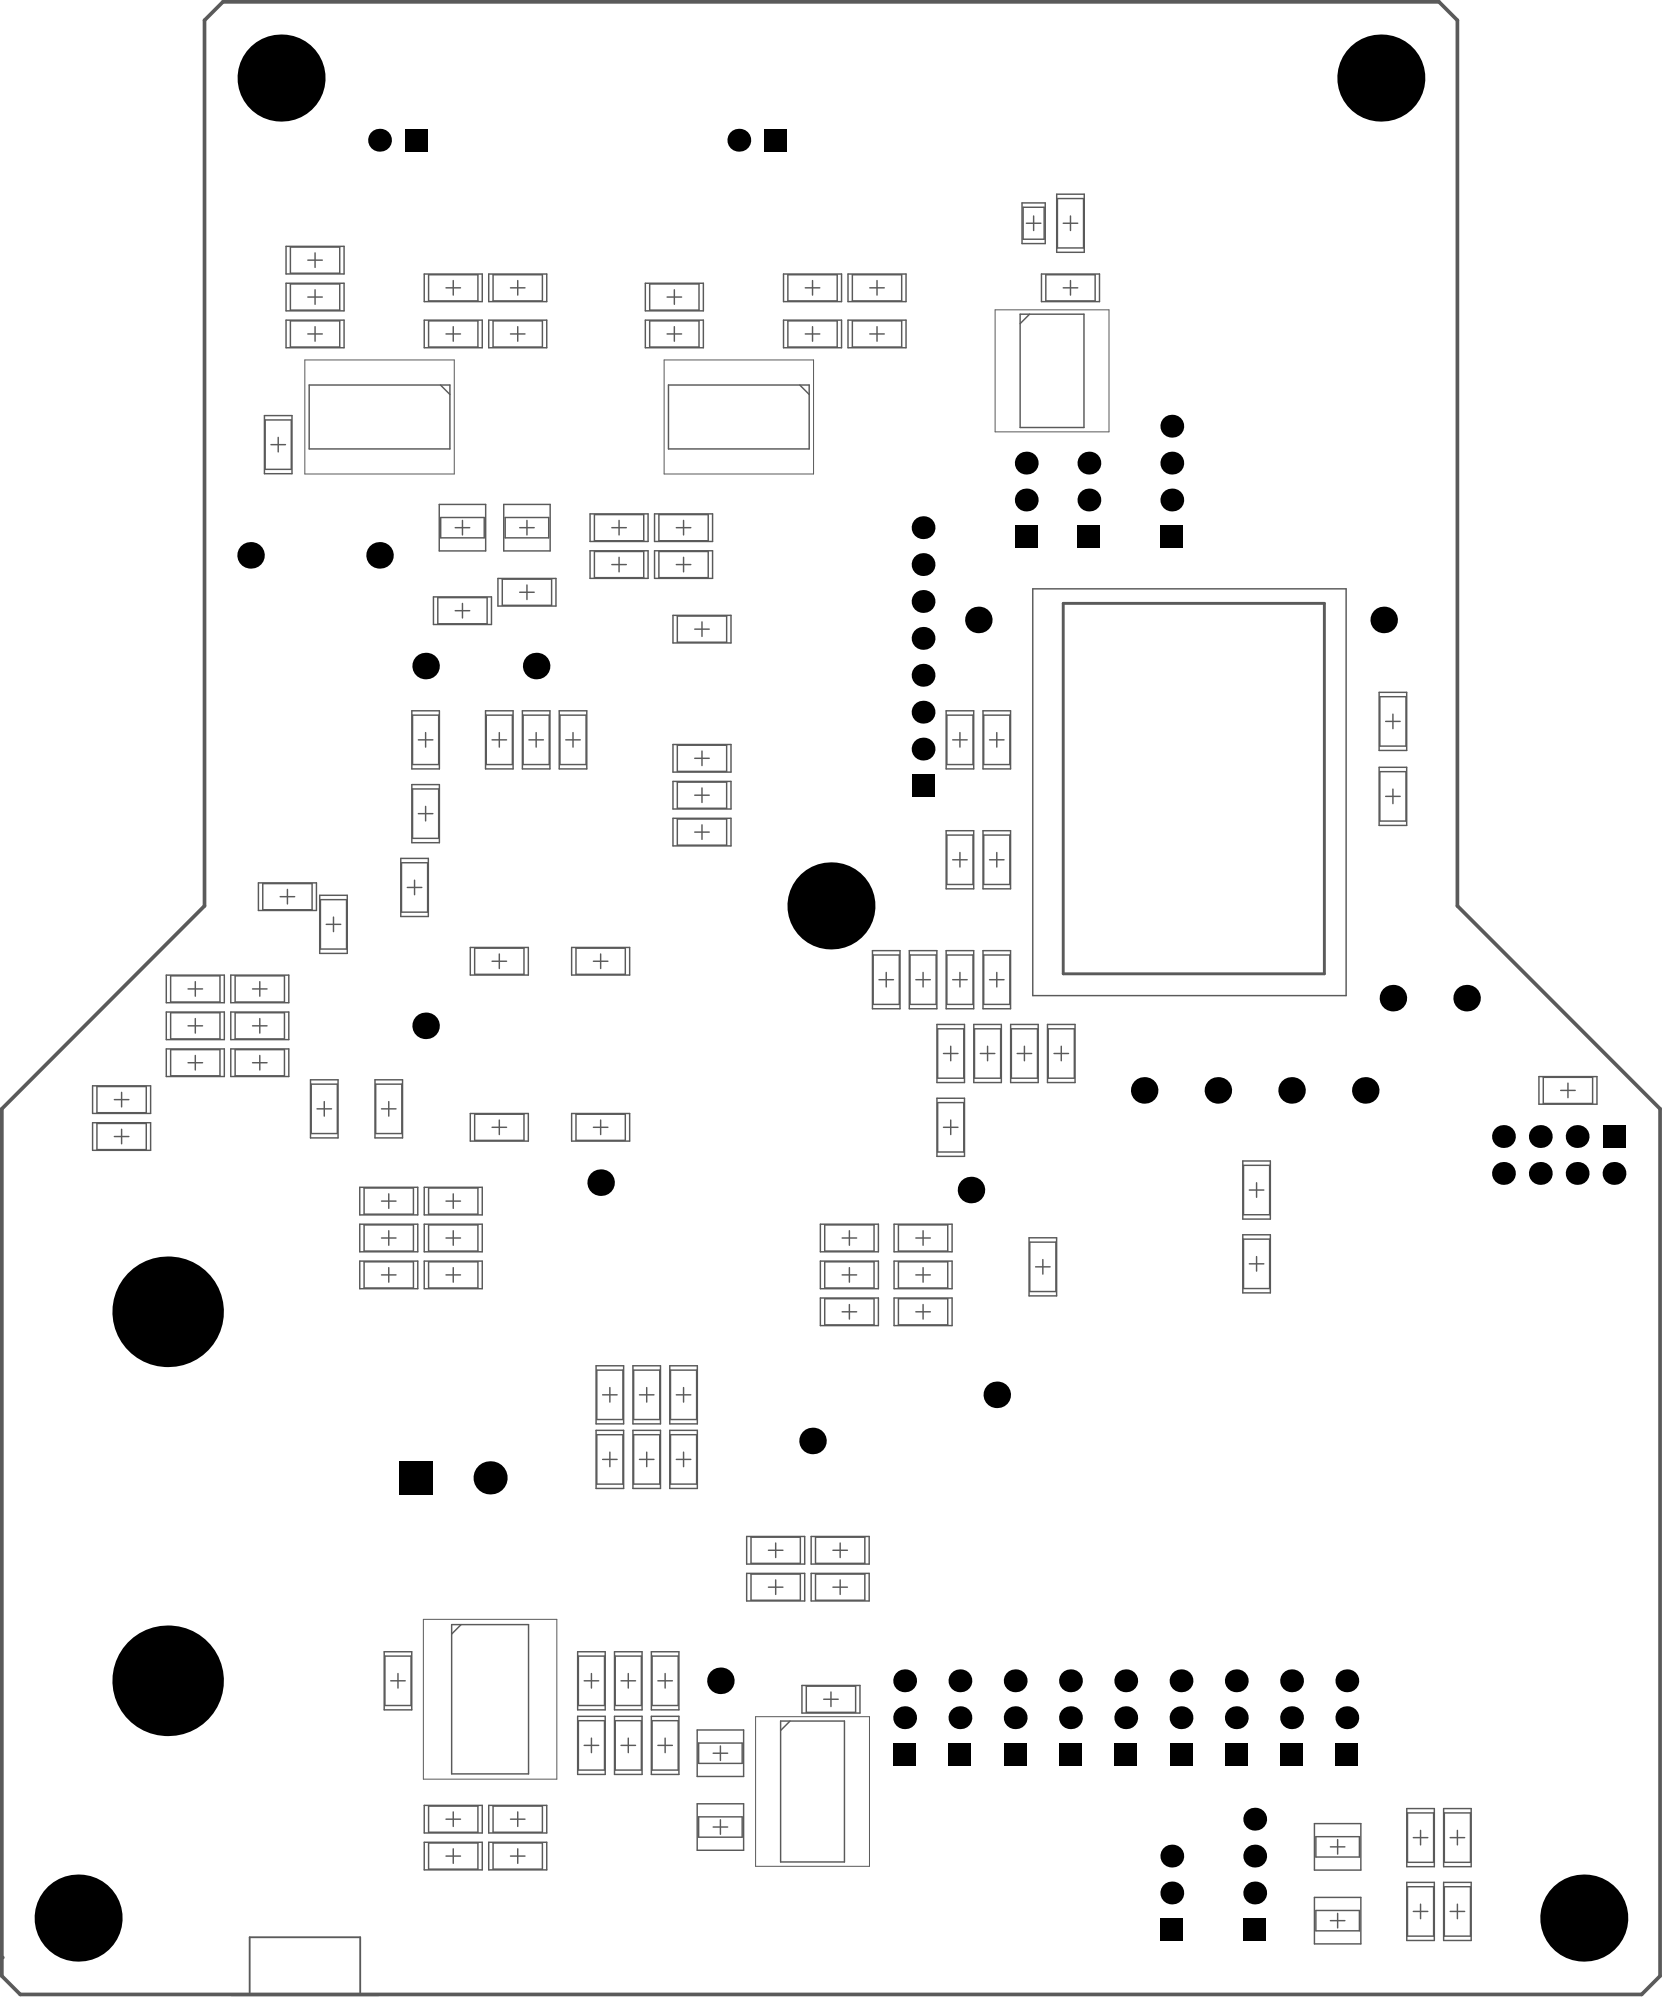
[picture p24: page 8]

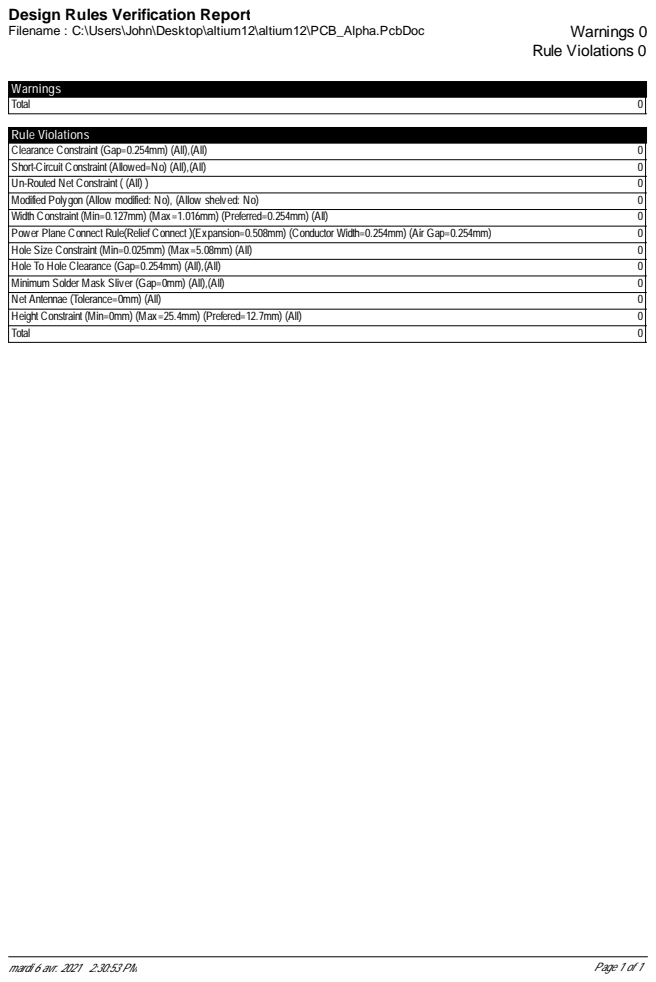
[picture p25: page 9]

Design Rules Verification Report

# Electrical Rules Check Report

Class | Document | Message
Error | main_control.SchDoc | Duplicate Component Designators C1_6
mardi 6 avr. 2021 2:30:55 PM | Page 1 of 1
