John-WL/Hydra-Alpha/board/altium/altium_alpha/PDF - 2021-04-07 11-20-59/Job1.PDF

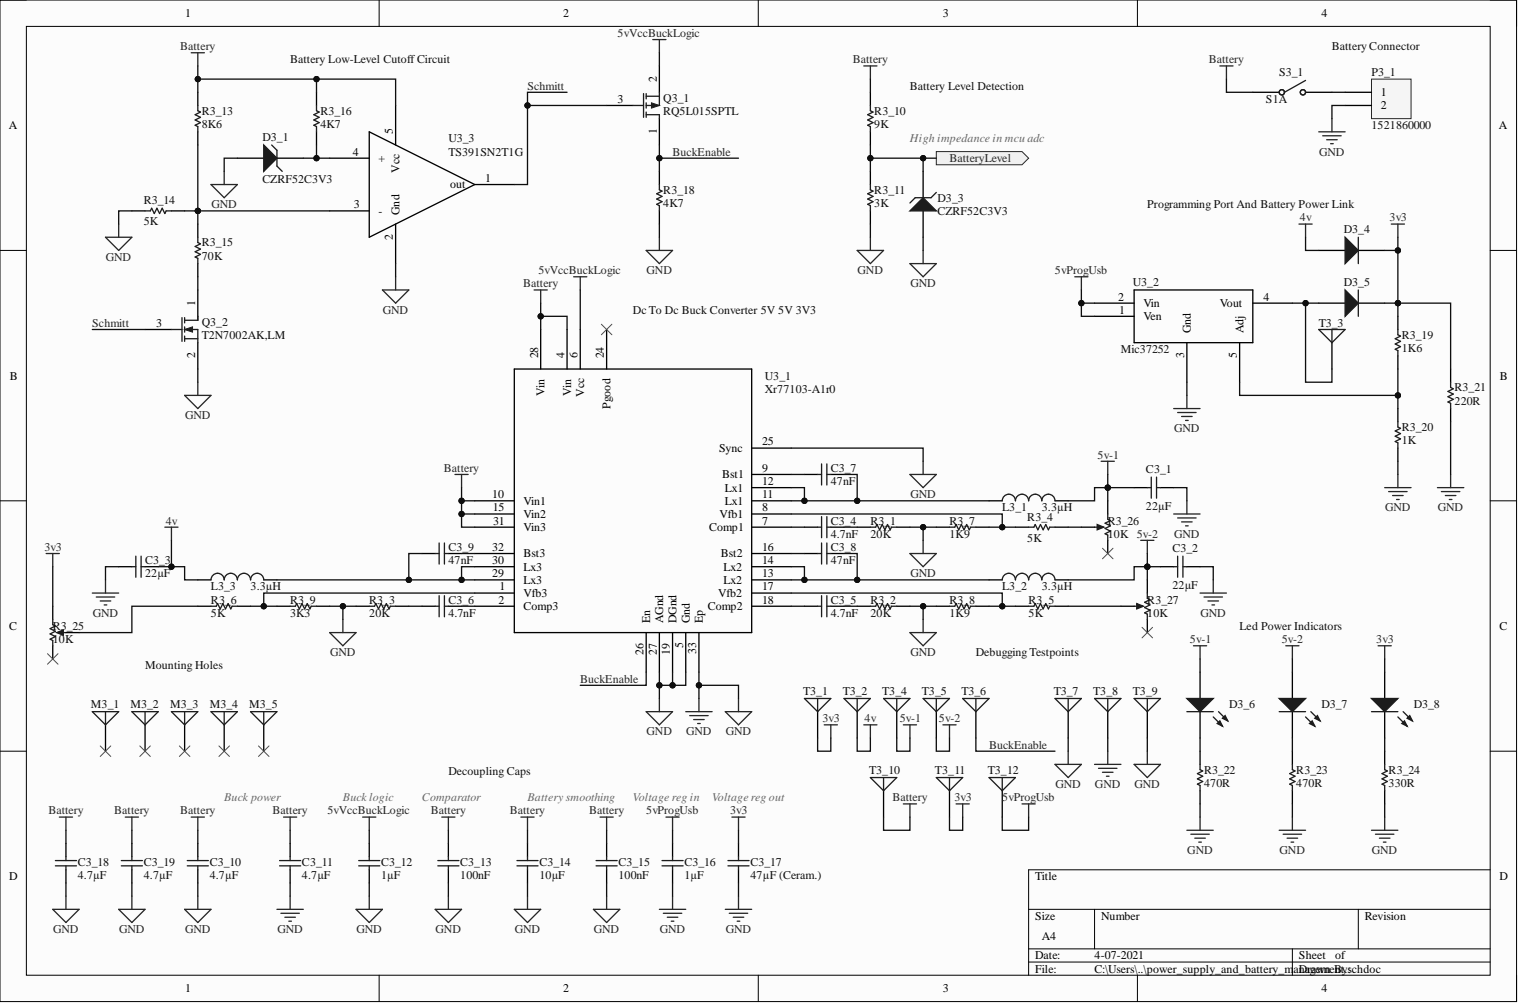
[picture p28: page 1]

Battery Low-Level Cutoff Circuit

High impedance in mcu adc

Programming Port And Battery Power Link

Dc To Dc Buck Converter 5V 5V 3V3

Vin3 31 Vin2 15 Vin1 10

Ep 33 Gnd 5 DGnd 19 AGnd 27 En 26

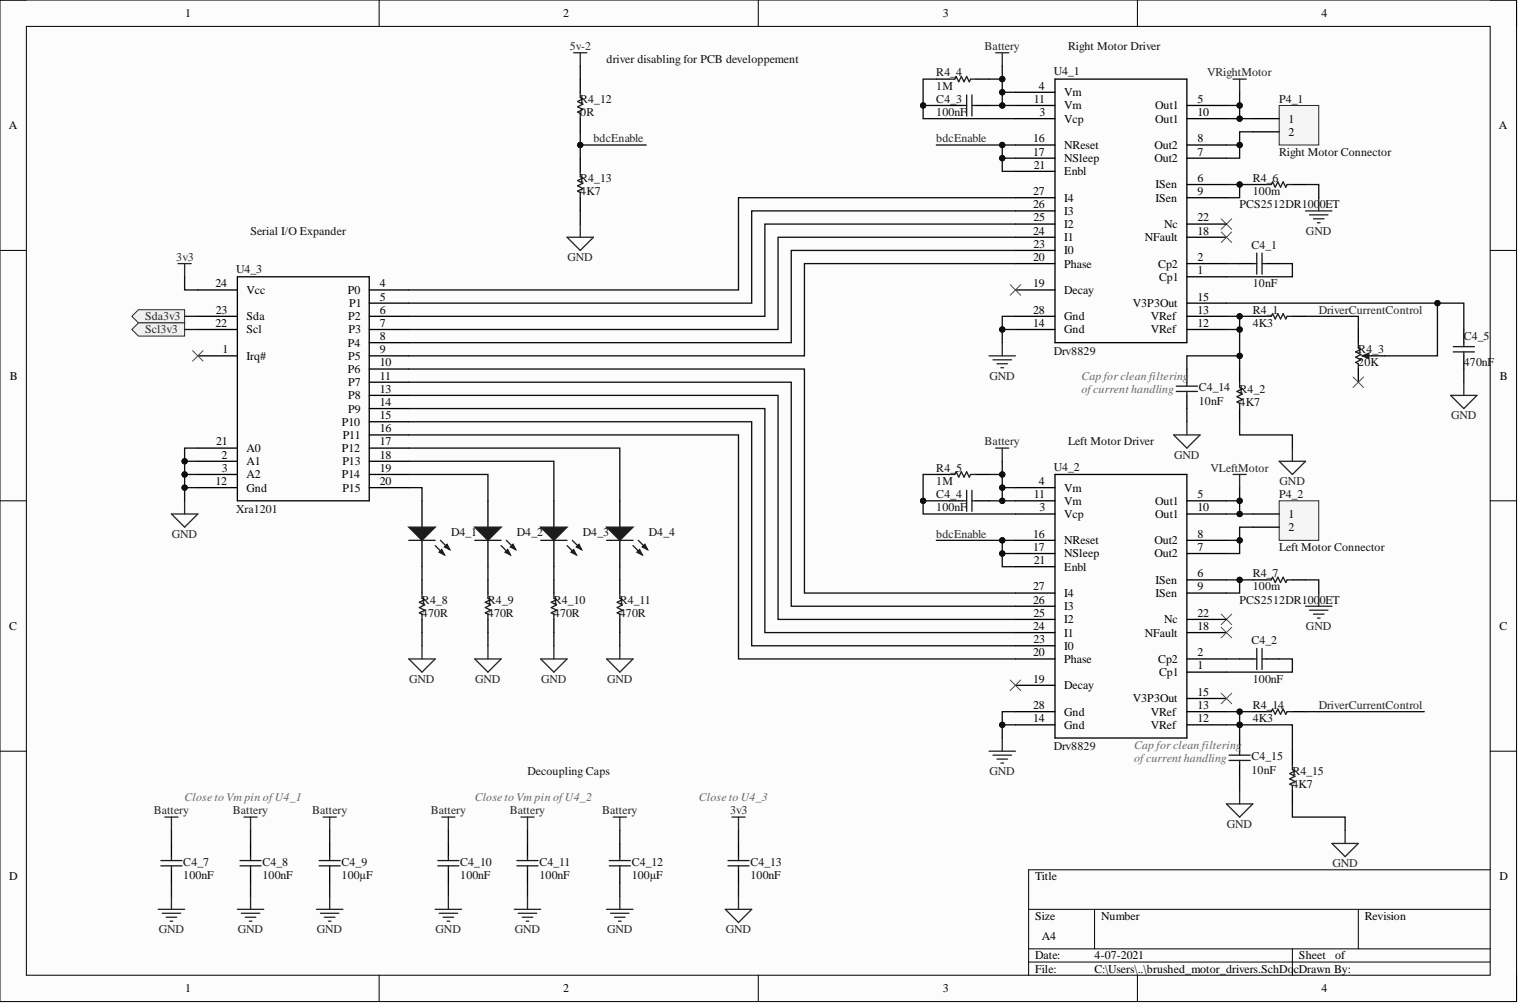
[picture p29: page 2]

driver disabling for PCB developpement

GND | Phase 20

Decay 19

Cap for clean filtering
of current handling

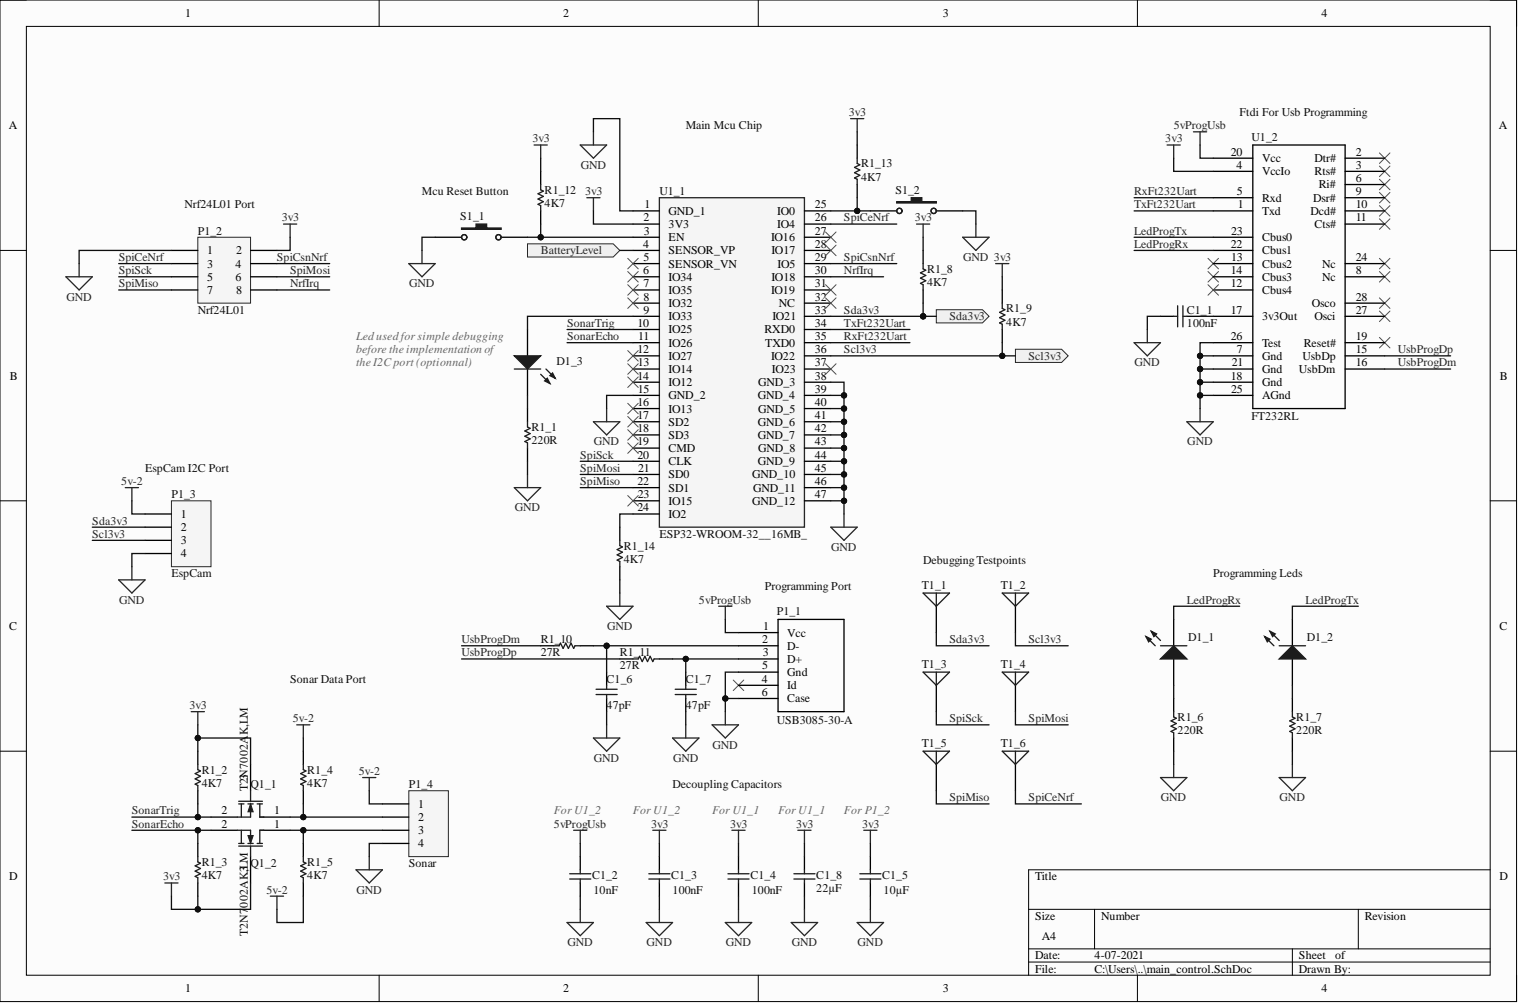
[picture p30: page 3]

Ftdi For Usb Programming

Led used for simple debugging
before the implementation of
the I2C port (optionnal)

Case 6 Id 4

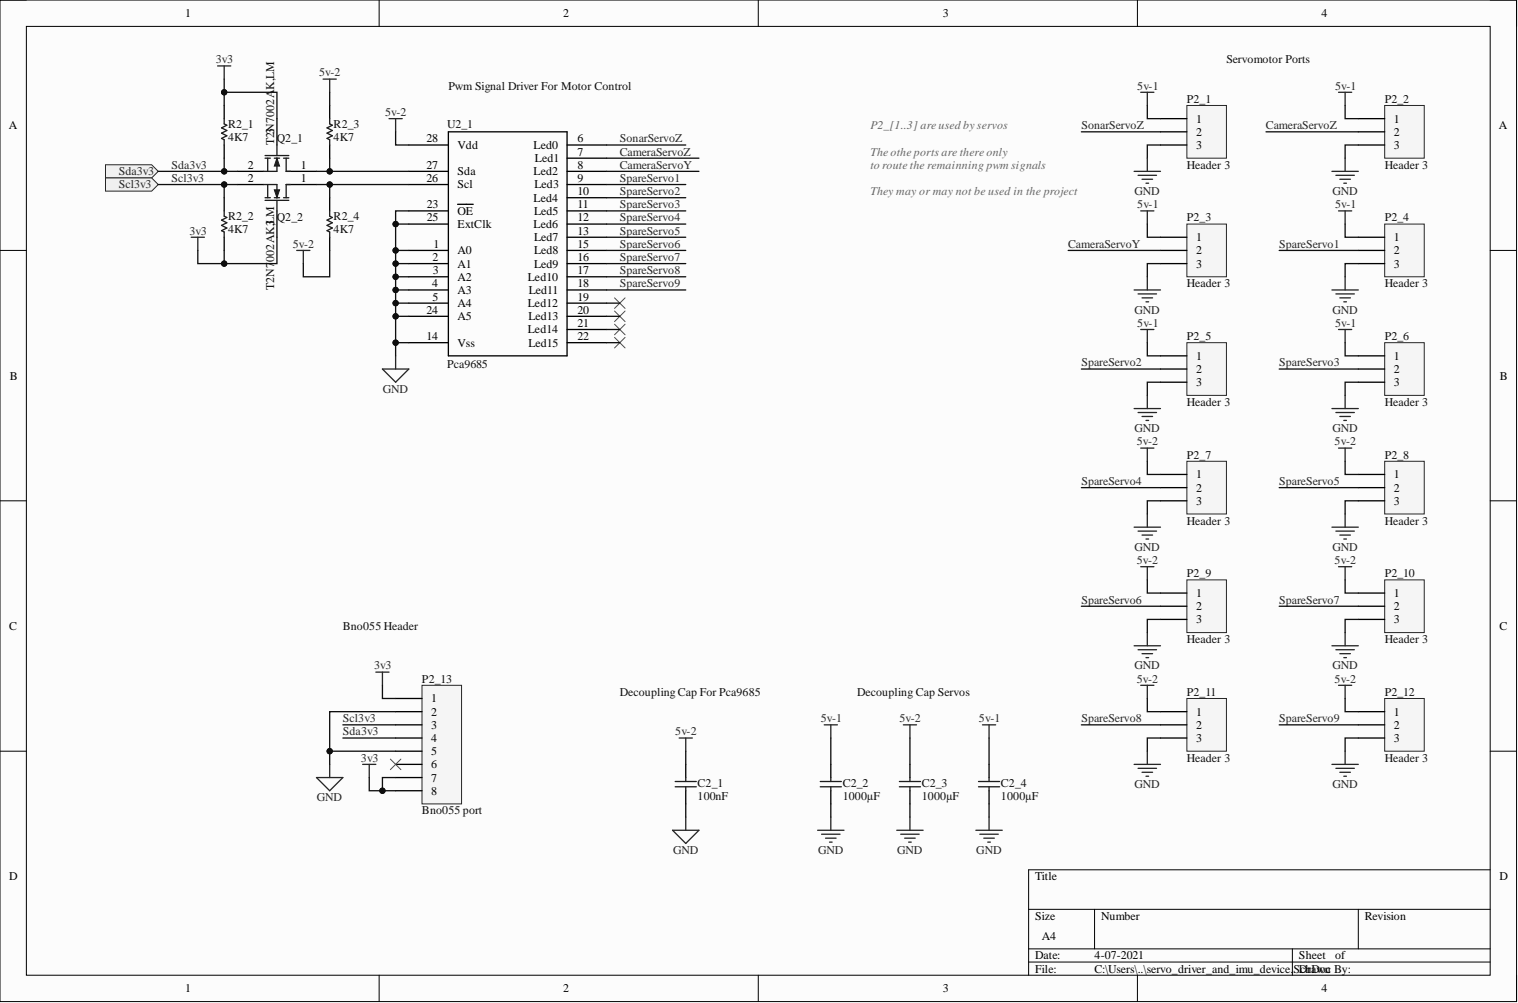
[picture p31: page 4]

Pwm Signal Driver For Motor Control

P2_[1..3] are used by servos

The othe ports are there only
to route the remainning pwm signals

They may or may not be used in the project

A3 4 | SpareServo9
A4 5
A5 24

Scl3v3 Sda3v3

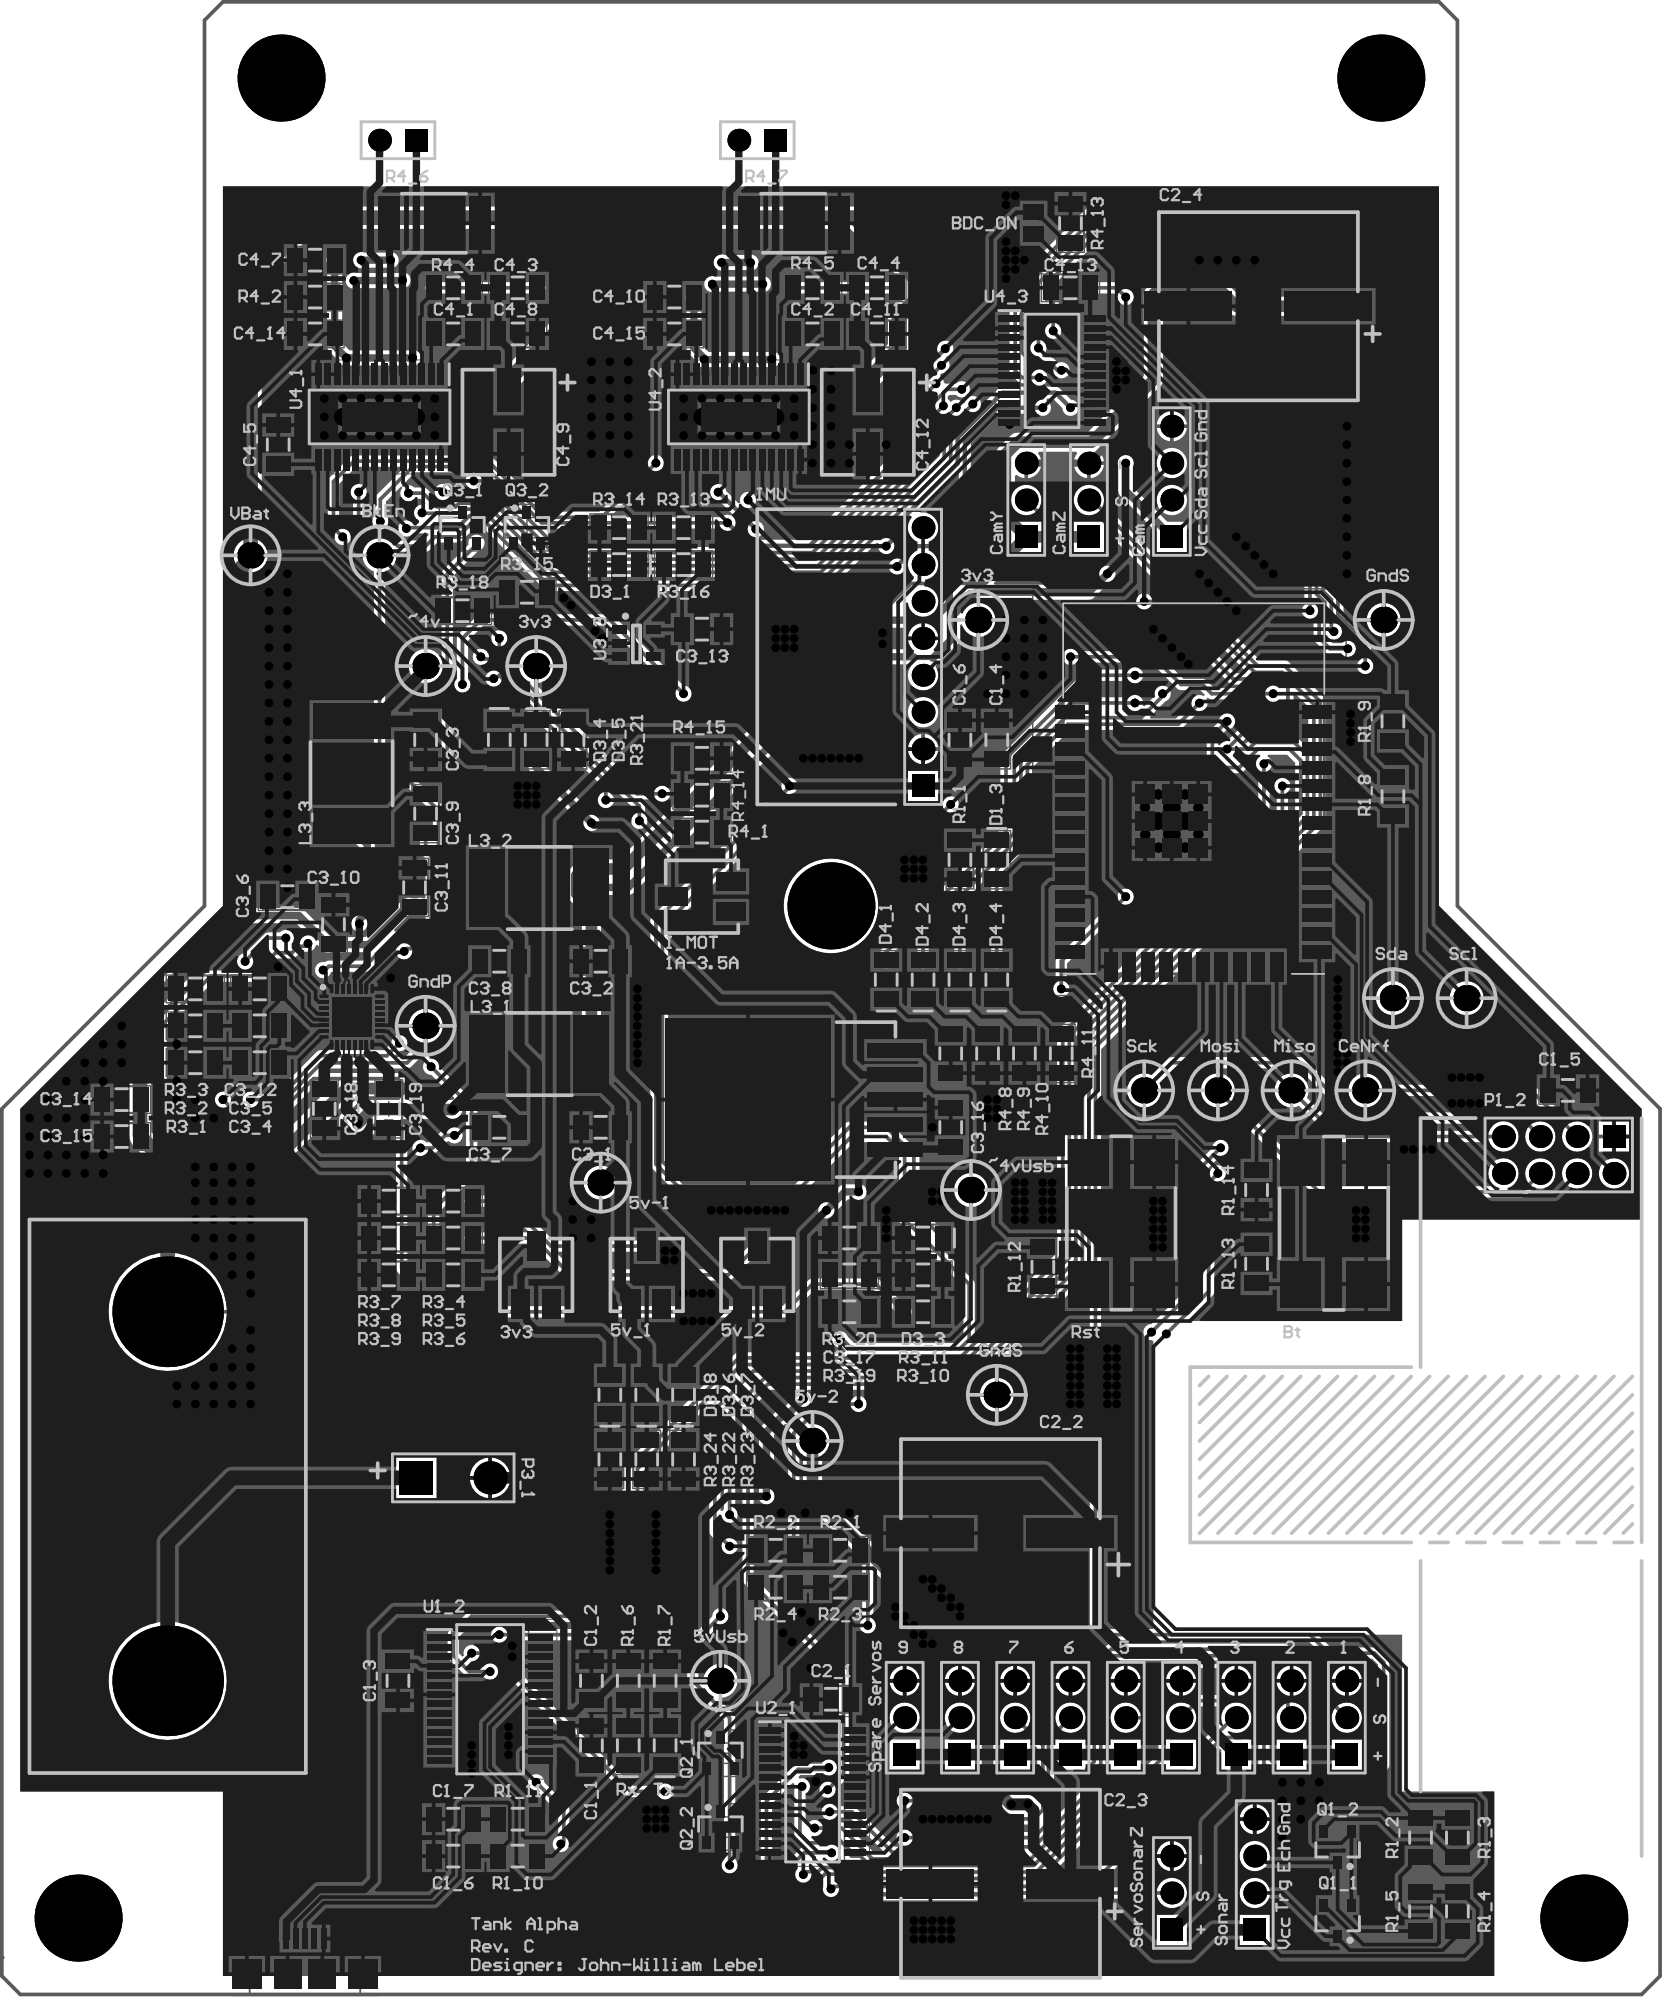
[picture p32: page 5]

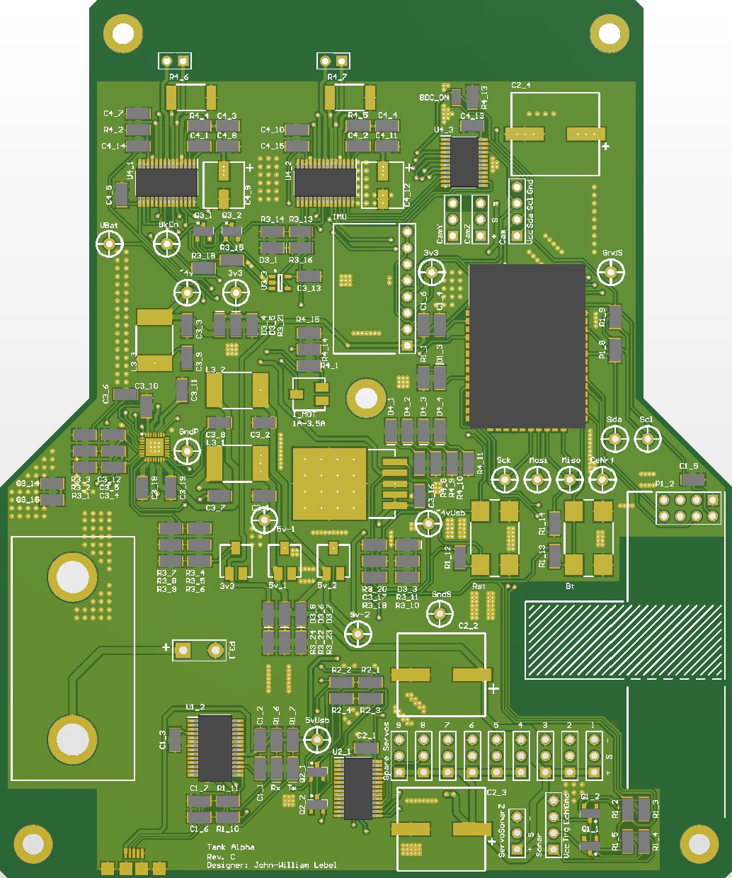
[picture p33: page 6]

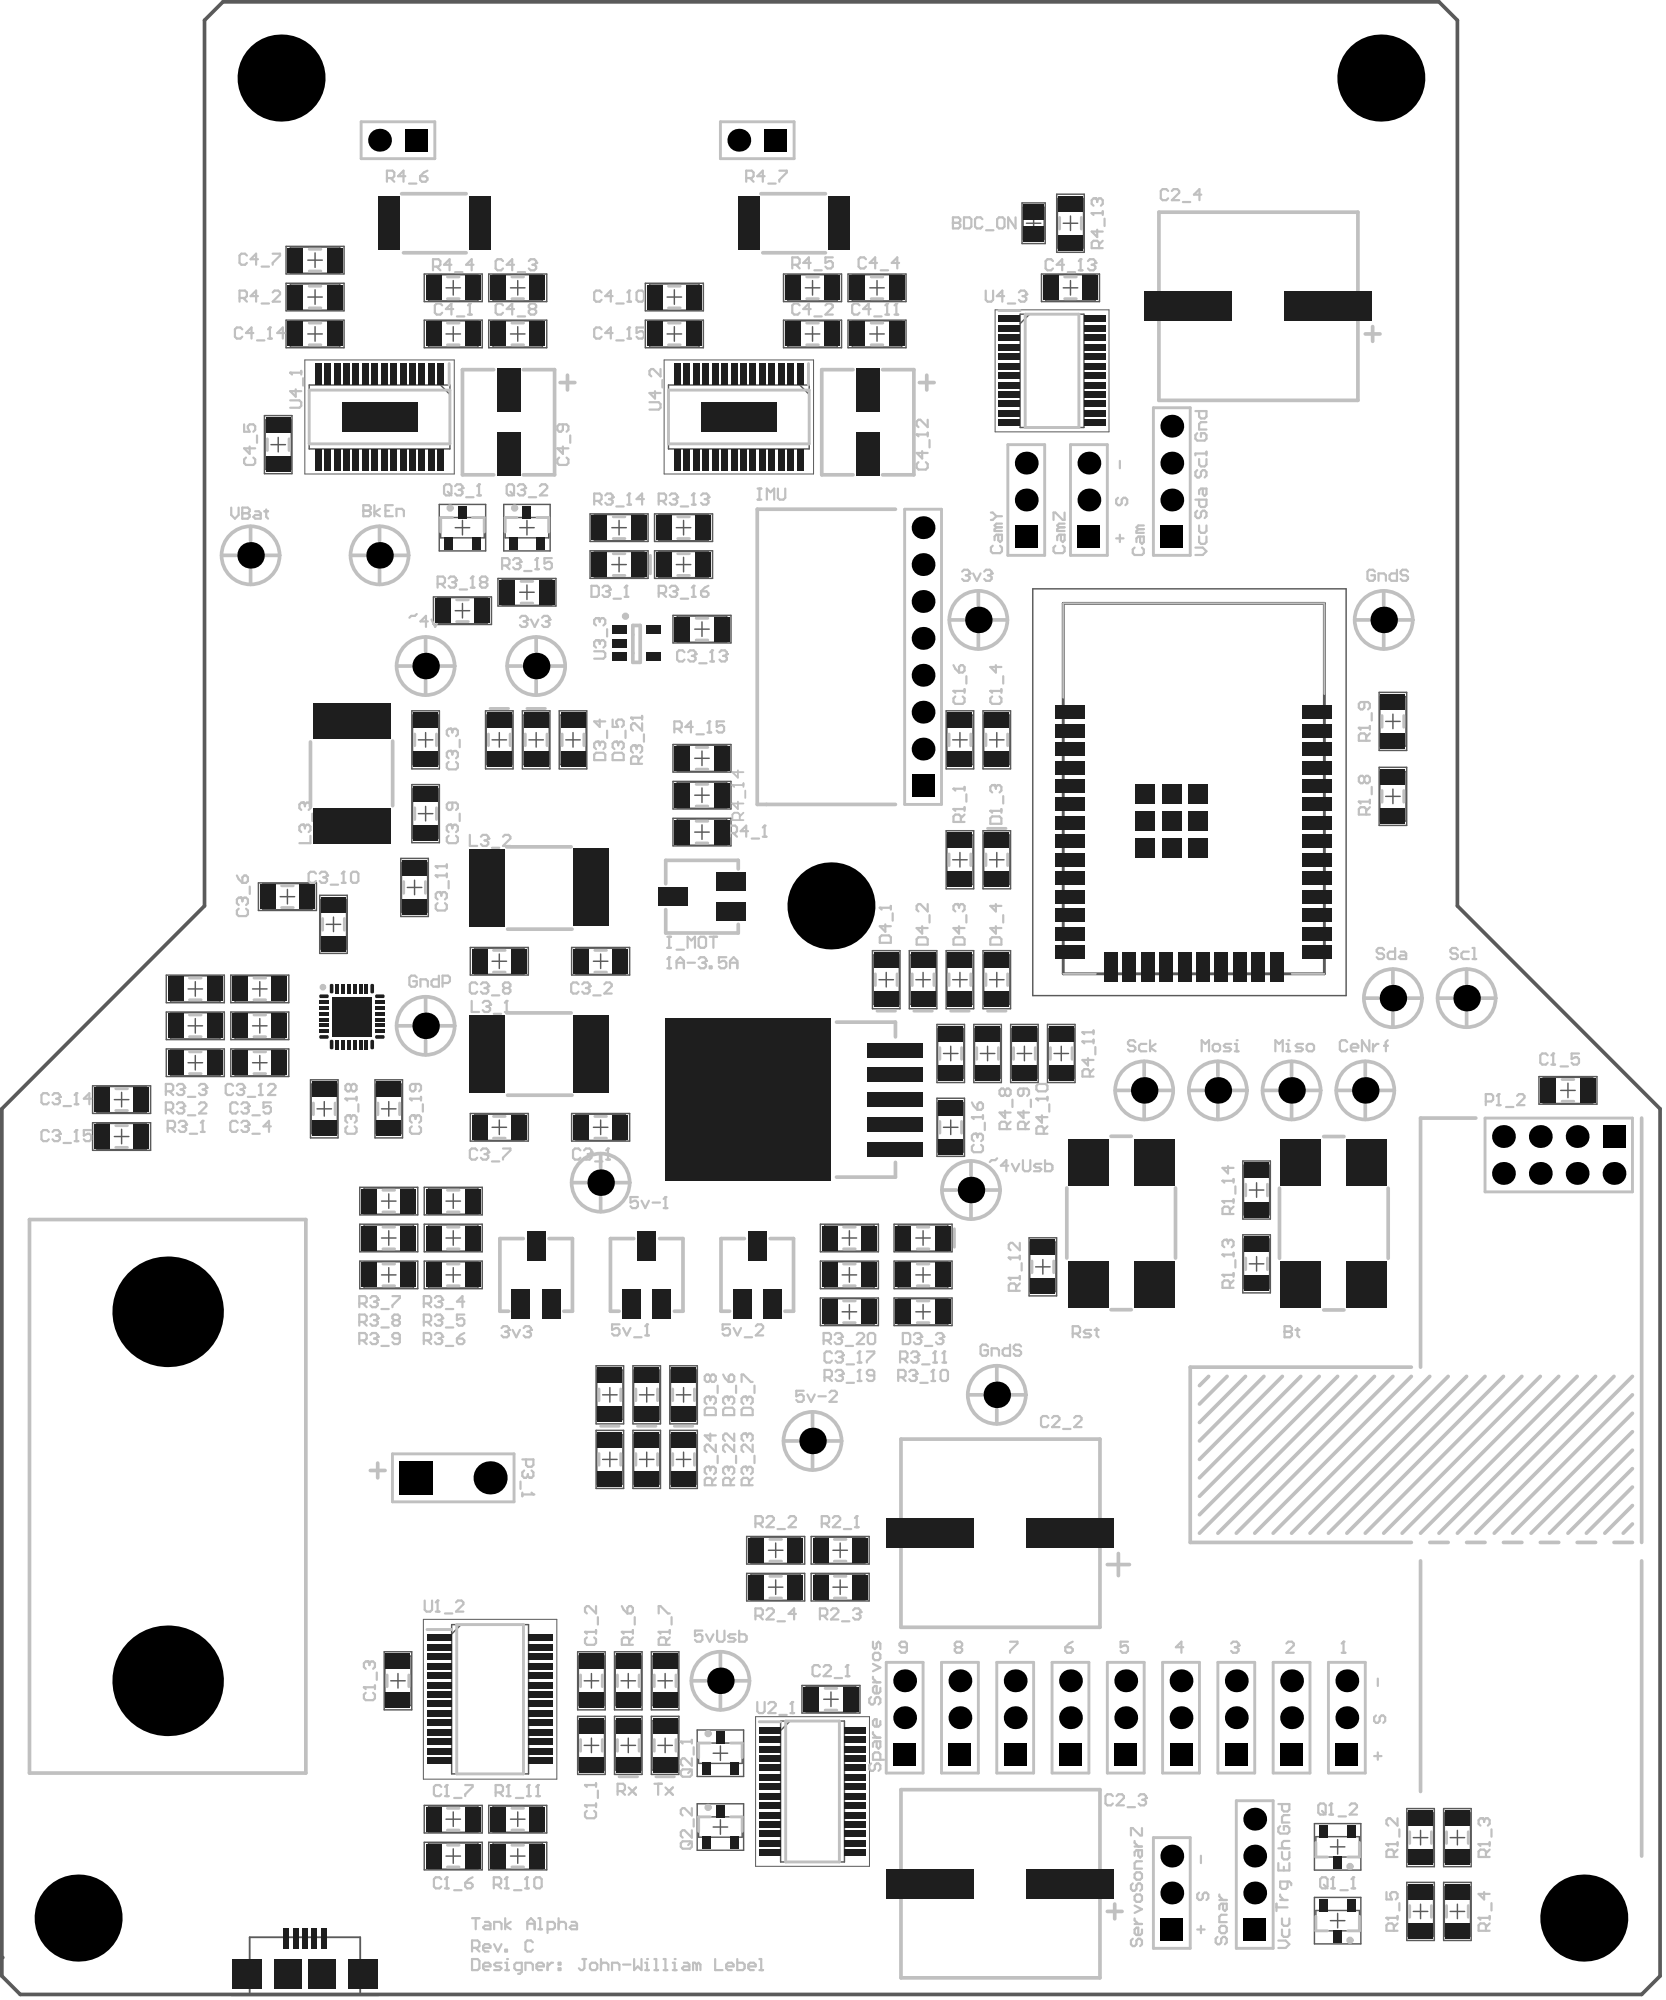
[picture p34: page 7]


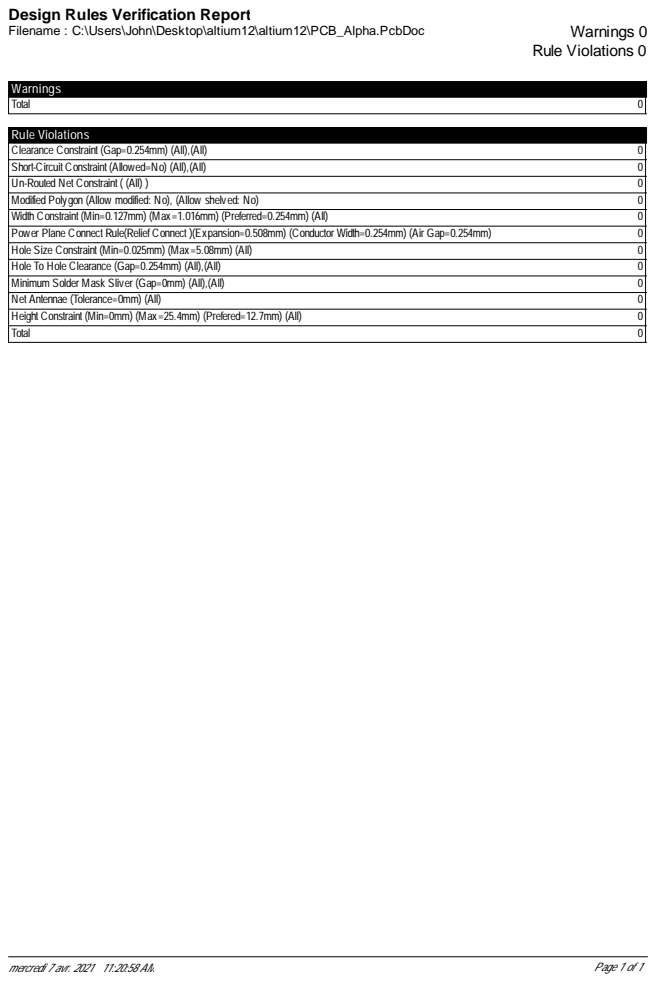
[picture p35: page 9]

Design Rules Verification Report

# Electrical Rules Check Report

Class | Document | Message Successful Compile for PCB_Hydra.PrjPcb
mercredi 7 avr. 2021 11:20:58 AM | Page 1 of 1
