John-WL/Hydra-Alpha/board/parts/ENG_CD_1977264_A2.pdf

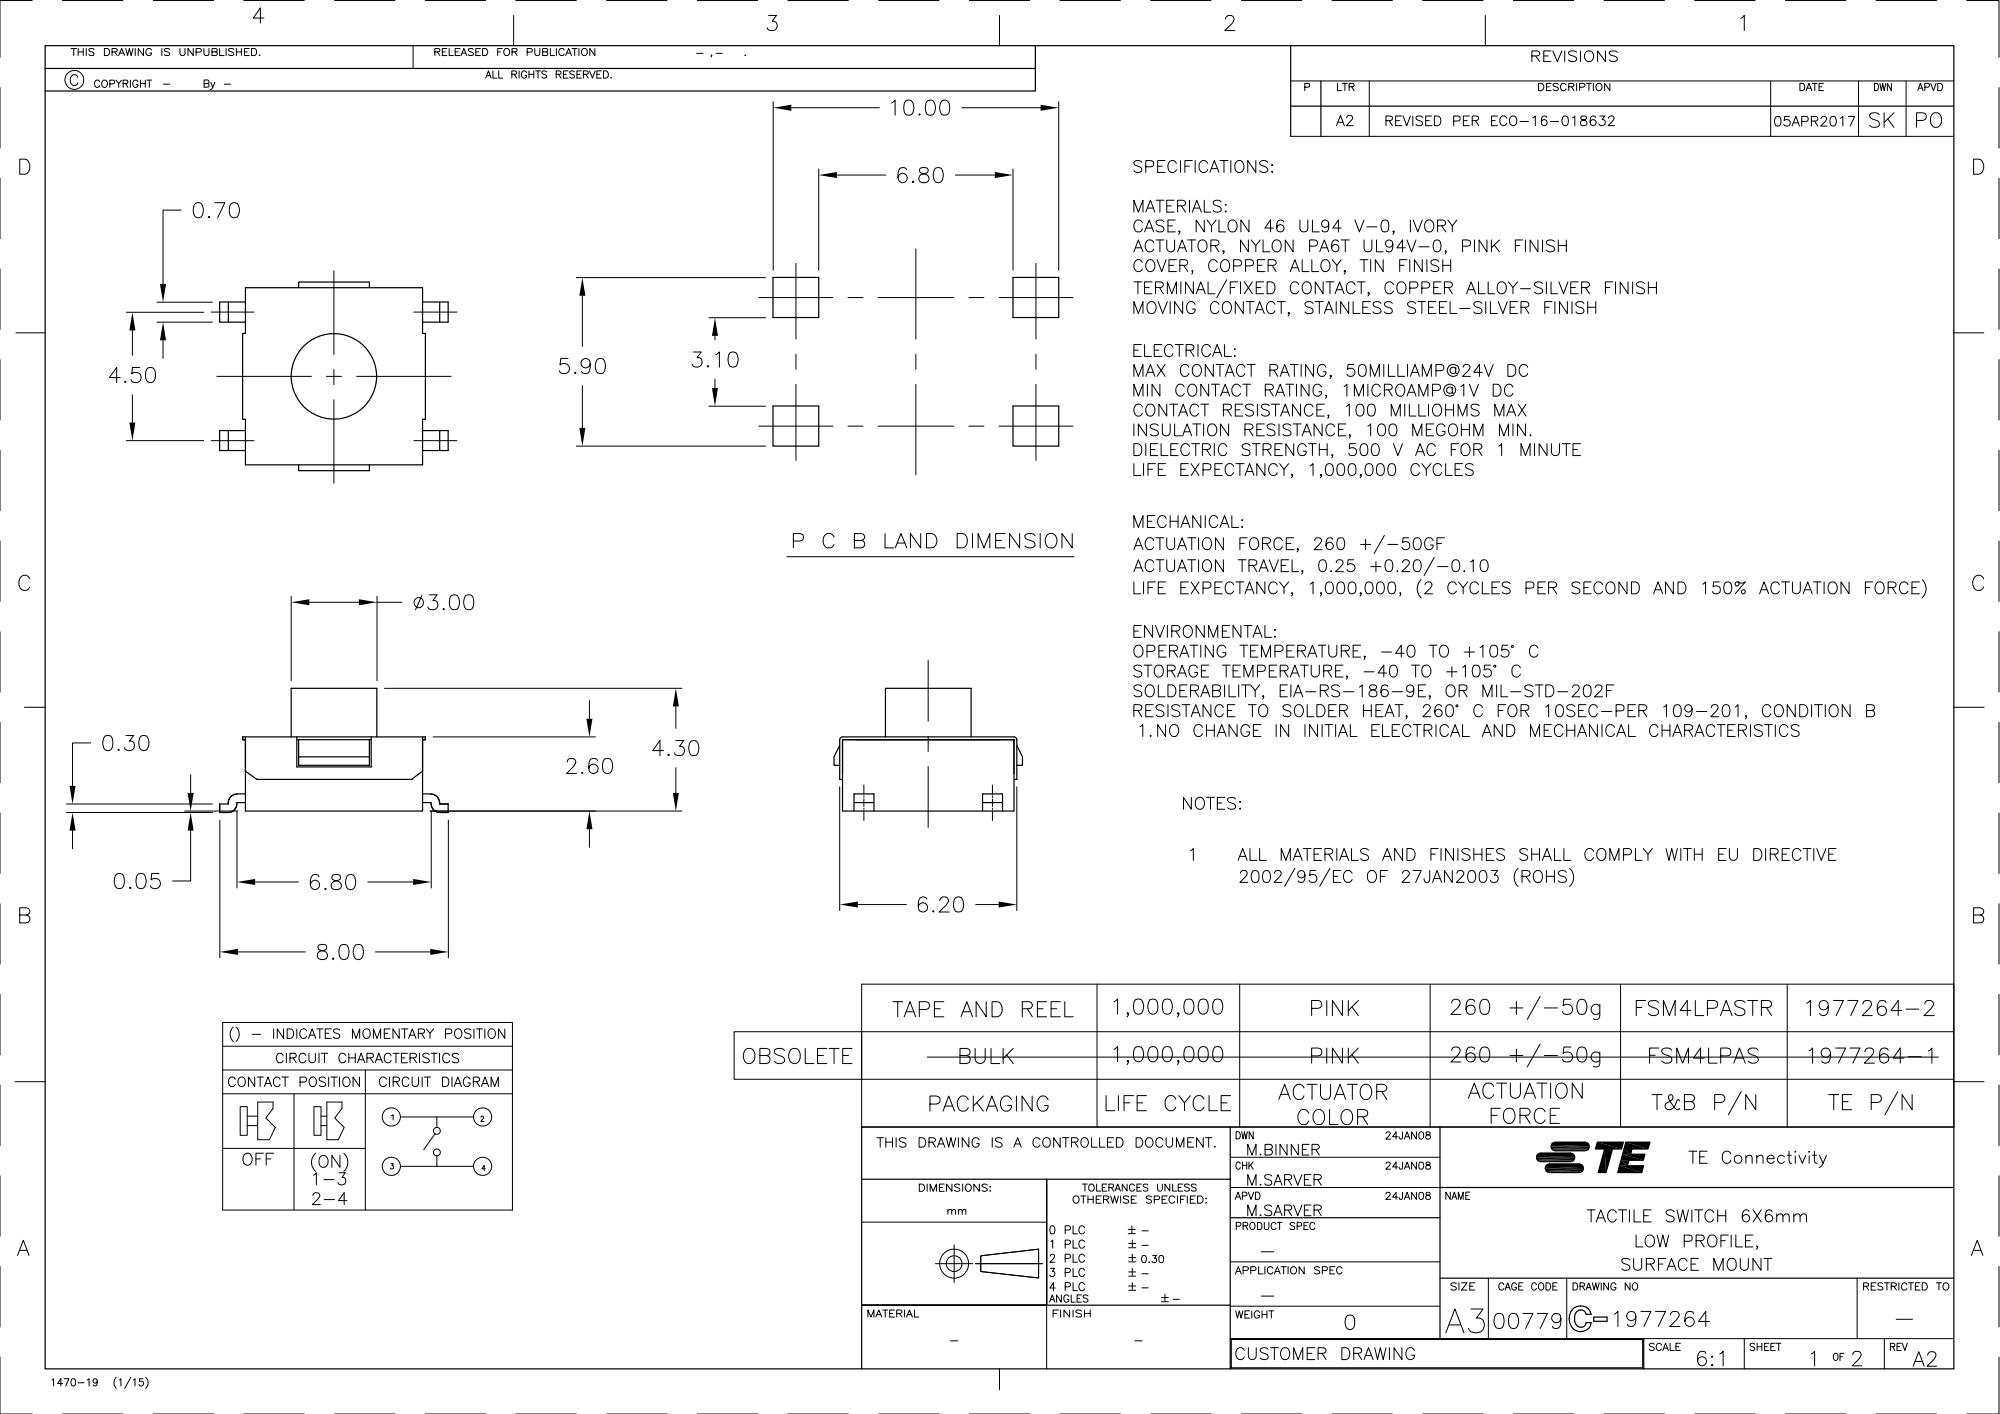
[picture p45: page 1]

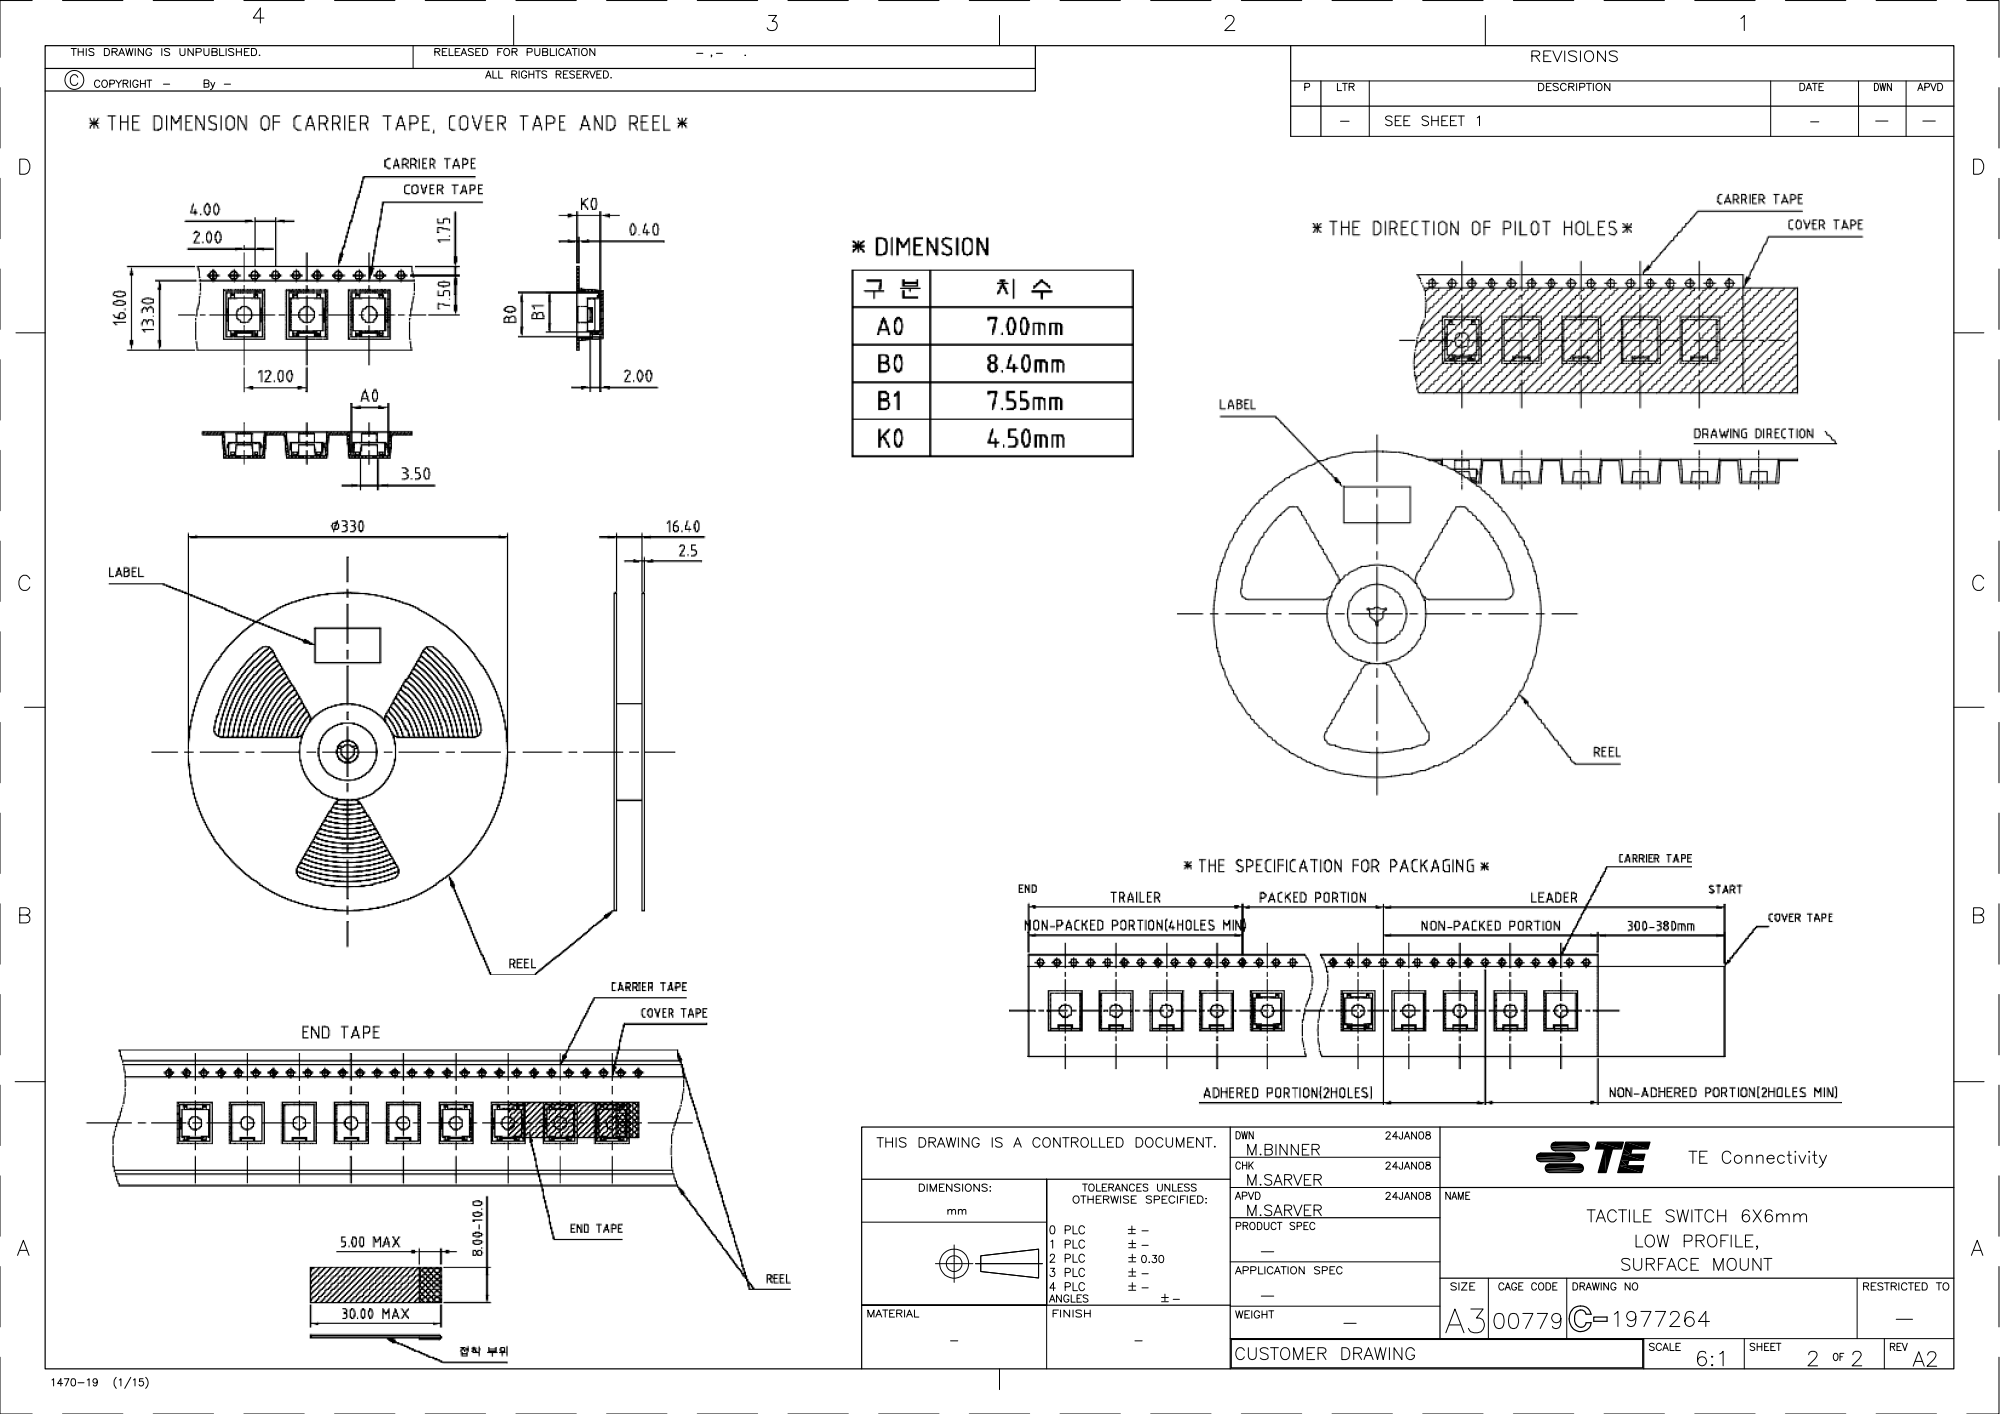
[picture p46: page 2]
