John-WL/Hydra-Alpha/(list of files, drawings)

Other design files:
board/altium/altium_alpha/brushed_motor_drivers.SchDoc
board/altium/altium_alpha/main_control.SchDoc
board/altium/altium_alpha/PCB_Alpha.PcbDoc
board/altium/altium_alpha/PCB_Hydra.PrjPcb
board/altium/altium_alpha/pcbLib/Miscellaneous Connectors.PcbLib
board/altium/altium_alpha/pcbLib/Miscellaneous Devices.PcbLib
board/altium/altium_alpha/pcbLib/PcbLib1.PcbLib
board/altium/altium_alpha/pcbLib/SamacSys.PcbLib
board/altium/altium_alpha/power_supply_and_battery_management.schdoc
board/altium/altium_alpha/schLib/Miscellaneous Connectors.SchLib
board/altium/altium_alpha/schLib/Miscellaneous Devices.SchLib
board/altium/altium_alpha/schLib/projet_6e_session.SchLib
board/altium/altium_alpha/schLib/SamacSys.SchLib
board/altium/altium_alpha/servo_driver_and_imu_device.SchDoc
board/altium/altium_camera_on_board/Project Hydra - CAM.PrjPcb
board/altium/altium_camera_on_board/Project Hydra - CAM.SCHLIB
board/altium/altium_camera_on_board/Support ESP32-CAM.PcbDoc
board/altium/altium_camera_on_board/Support ESP32-CAM.PcbLib
board/altium/altium_camera_on_board/Support ESP32-CAM.SchDoc
board/multisim simulations/asymetric delay gate.ms14
