John-WL/Hydra-Alpha/prog/code/hydra_alpha_v1/src/tank/io/output/bdc_motor/BdcMotor.h

// Author: John-William Lebel, 2021-04-11, creation

// class used to control the bdc motors

#ifndef BDC_MOTOR_H
#define BDC_MOTOR_H

#include "../../../utils/controllers/pulse_controller/Int8_tPulseController.h"

#define MAX_BDC_MOTOR_TORQUE 31
#define MIN_BDC_MOTOR_TORQUE -31

#define BDC_MOTOR_BITS_PER_CHANNEL 6

class BdcMotor
{
    public:
        BdcMotor(uint8_t channelNumber, uint8_t pwmPinNumber);
        BdcMotor(uint8_t channelNumber, uint8_t pwmPinNumber, float* bdcPwmValues);
        void update();
        void setMotorTorque(float desiredTorque);

    private:
        uint8_t _channelNumber;
        uint8_t _pwmPinNumber;
        float _motorTorque;
        Int8_tPulseController _pulseController;
        float* _bdcPwmValues;
};

#endif
