John-WL/Hydra-Alpha/prog/code/hydra_basic_remote_v1/src/remote/peripheral/wifi_server_hydra/WiFiServerHydra.h

#ifndef WI_FI_SERVER_HYDRA_H
#define WI_FI_SERVER_HYDRA_H

#include "WiFi.h"
#include "ArduinoWebsockets.h"

#include "Vector.h"

#define WI_FI_SERVER_SSID "Hydra::Remote"
#define WI_FI_SERVER_PASSWORD "S.H.I.E.L.D."

#define WI_FI_SERVER_IP "192.168.4.1"
#define WI_FI_SERVER_PORT 8888

//#define ENABLE_SIMULTANEOUS_RECEPTION

class WiFiServerHydra
{
public:
    static void init();
    static void update(void (*messageHandler)(websockets::WebsocketsMessage*, uint8_t));

private:
    static websockets::WebsocketsMessage _receiveDataFrom(websockets::WebsocketsClient* client);

    static uint8_t _amountOfConnectedClients;
    static websockets::WebsocketsServer _server;
    static websockets::WebsocketsClient _clients[2];

};

#endif
