John-WL/Hydra-Alpha/prog/code/hydra_alpha_v1/src/tank/mode/ListeningToYourCommands.cpp

// Author: John-William Lebel, 2021-04-08, creation

#include "ListeningToYourCommands.h"

#include "FunctioningMode.h"

#include "Arduino.h"

#include "../io/output/Outputs.h"

#include "../peripheral/protocol_format/IncommingCommunicationFormat.h"
#include "../peripheral/protocol_format/OutgoingCommunicationFormat.h"

#include "../peripheral/serial/esp_cam/EspCam.h"

#include "../io/input/sonar/Sonar.h"
#include "../io/input/battery/BatteryVoltageSensor.h"

#include "../peripheral/protocol_format/DataConverter.h"
#include "../peripheral/spi/HydraRF/HydraRF.h"

void ListeningToYourCommands::execute(IncommingCommunicationFormat input)
{
    // update the functionning mode
    FunctioningMode::set(input.mode);

    // update bdc motors
    Outputs::bdcMotorLeft.setMotorTorque(input.throttle - input.steer);
    Outputs::bdcMotorRight.setMotorTorque(-(input.throttle + input.steer));

    // udate the servo motors
    Outputs::servoMotorSonarZ.setMotorAngle(input.sonarAngleZ);
    Outputs::servoMotorCameraZ.setMotorAngle(input.cameraAngleZ);
    Outputs::servoMotorCameraY.setMotorAngle(input.cameraAngleY);

    // handle EspCam sending camera feed over WiFi
    EspCam::enableSendingImagesOverWifi(input.wiFiCameraEnabled);

    OutgoingCommunicationFormat output{};
    output.mode = input.mode;
    output.distanceSonar = Sonar::measuredDistance;
    output.batteryLevel = BatteryVoltageSensor::getValue();

    // TrameAlpha is defined in "HydraRF.h"
    DataConverter::translate(&output, &TrameAlpha);
}
