John-WL/Hydra-Alpha/prog/code/hydra_alpha_v1/src/tank/mode/ListeningToYourCommands.h

// Author: John-William Lebel, 2021-04-08, creation

// in this mode, we just listen to the inputs sent by the controller, 
// and forward the corresponding values to all the motors (BDC and sevos)

#ifndef LISTENING_TO_YOUR_COMMANDS_H
#define LISTENING_TO_YOUR_COMMANDS_H

#include "../peripheral/protocol_format/IncommingCommunicationFormat.h"

class ListeningToYourCommands
{
public:
    static void execute(IncommingCommunicationFormat input);
    
private:

};

#endif
