John-WL/Hydra-Alpha/prog/code/tests and utils/bear_minimum_for_espcam_camera_sensor_without_WiFi/bear_minimum_for_espcam_camera_sensor_without_WiFi.ino

#include "esp_camera.h"
#include <WiFi.h>

// Select camera model
//#define CAMERA_MODEL_WROVER_KIT
//#define CAMERA_MODEL_ESP_EYE
//#define CAMERA_MODEL_M5STACK_PSRAM
//#define CAMERA_MODEL_M5STACK_WIDE
#define CAMERA_MODEL_AI_THINKER

#include "camera_pins.h"

const char* ssid = "*********";
const char* password = "*********";

void handleCameraTransmission();

void setup()
{
  Serial.begin(115200);
  Serial.setDebugOutput(true);
  Serial.println();

  camera_config_t config;
  config.ledc_channel = LEDC_CHANNEL_0;
  config.ledc_timer = LEDC_TIMER_0;
  config.pin_d0 = Y2_GPIO_NUM;
  config.pin_d1 = Y3_GPIO_NUM;
  config.pin_d2 = Y4_GPIO_NUM;
  config.pin_d3 = Y5_GPIO_NUM;
  config.pin_d4 = Y6_GPIO_NUM;
  config.pin_d5 = Y7_GPIO_NUM;
  config.pin_d6 = Y8_GPIO_NUM;
  config.pin_d7 = Y9_GPIO_NUM;
  config.pin_xclk = XCLK_GPIO_NUM;
  config.pin_pclk = PCLK_GPIO_NUM;
  config.pin_vsync = VSYNC_GPIO_NUM;
  config.pin_href = HREF_GPIO_NUM;
  config.pin_sscb_sda = SIOD_GPIO_NUM;
  config.pin_sscb_scl = SIOC_GPIO_NUM;
  config.pin_pwdn = PWDN_GPIO_NUM;
  config.pin_reset = RESET_GPIO_NUM;
  config.xclk_freq_hz = 20000000;
  config.pixel_format = PIXFORMAT_JPEG;
  
  // initialize with high specs to pre-allocate larger buffers

  // here, my guess is that if we don't have a lot of memory, 
  // we allocate a less memory consuming JPEG format?
  if(psramFound())
  {
    config.frame_size = FRAMESIZE_UXGA;
    config.jpeg_quality = 10;
    config.fb_count = 2;
  }
  else
  {
    config.frame_size = FRAMESIZE_SVGA;
    config.jpeg_quality = 12;
    config.fb_count = 1;
  }

#if defined(CAMERA_MODEL_ESP_EYE)
  pinMode(13, INPUT_PULLUP);
  pinMode(14, INPUT_PULLUP);
#endif

  // camera initialization
  esp_err_t err = esp_camera_init(&config);
  if (err != ESP_OK)
  {
    Serial.printf("Camera init failed with error 0x%x", err);
    return;
  }

  // Ça, on dirait l'objet camera pour prendre des photos.
  // C'est quoi les foutues méthodes qu'on peut utiliser avec?????
  sensor_t* s = esp_camera_sensor_get();

  // Initial sensors are flipped vertically and colors are a bit saturated.
  // Ici, on dirait qu'ils set les settings de la camera 
  // en fonction de la board utilisé.
  if (s->id.PID == OV3660_PID)
  {
    s->set_vflip(s, 1);//flip it back
    s->set_brightness(s, 1);//up the blightness just a bit
    s->set_saturation(s, -2);//lower the saturation
  }
  
  // Drop down frame size for higher initial frame rate.
  // POURQUOI on a besoin de faire ça????
  // Est-ce que c'est un fix pour le WiFi UNIQUEMENT,
  // OU est-ce que c'est un fix UNIVERSEL, genre le module marche juste pas si on met pas ça?????
  // Est-ce que c'est juste pour faire beau??????
  s->set_framesize(s, FRAMESIZE_QVGA);

  // some more settings on dirait pour la caméra d'une board qu'on utilise pas
#if defined(CAMERA_MODEL_M5STACK_WIDE)
  s->set_vflip(s, 1);
  s->set_hmirror(s, 1);
#endif

  // Bon, pis là, on rentre dans la partie qu'on veut principalement modifier.
  /*
    // Bon, jusque là, je comprends ce qu'ils font...
    WiFi.begin(ssid, password);

    // On boucle jusqu'à ce que ce soit connecté...
    while (WiFi.status() != WL_CONNECTED) {
      delay(500);
      Serial.print(".");
    }
    Serial.println("");
    Serial.println("WiFi connected");

    // On start le programme?
    // Est-ce que le programme run sur des interrupts?
    // Sur des callbacks?
    // C'est quoi qui dit au processeur "hey wake up on a une request WiFi envoie du data"???
    startCameraServer();

    // some more debug info, nobody cares
    Serial.print("Camera Ready! Use 'http://");
    Serial.print(WiFi.localIP());
    Serial.println("' to connect");
  */

  // Ça, c'est la partie que je mettrait:
  handleCameraTransmission();
  
}

void loop()
{
  // wtf is this, pourquoi on a besoin d'une boucle ici???
  delay(1000);
}
