John-WL/Hydra-Alpha/prog/code/hydra_alpha_v1/src/tank/io/input/sonar/SonarScanner.h

#ifndef SONAR_SCANNER
#define SONAR_SCANNER

#include "SonarSample.h"
#include "../../../../shared/utils/data_structure/CircularBuffer.h"
#include "vector.h"

#define MAX_AMOUNT_OF_SONAR_SAMPLES 20
#define DISTANCE_THREASHOLD_TO_BE_CONSIDERED_VALID 200

class SonarScanner
{
public:
    static void init();
    static void update();
    static float getDesiredSonarAngle();
    static void _addDataPoint(SonarSample sonarSample);
    static std::vector<SonarSample> findDrivableSamples();

private:
    static CircularBuffer<SonarSample> _sonarSampleBuffer;

};

#endif
