John-WL/Hydra-Alpha/(commit log)

2021-04-13 Initial commit. Board in altium is practicaly done, some code has been written
    [Bill of Materials-PCB_Hydra.xlsx, DRV8829PWP.stl, DRV8829PWP.stp, EDI2CAP.CFG, ESP32-WROOM-32__16MB_.stl, ESP32-WROOM-32__16MB_.stp, FT232RL.stl, FT232RL.stp]
2021-04-13 added sonar, pca9685 and servo motors, plus some minor changes
    [Bill of Materials-PCB_Hydra.xlsx, DRV8829PWP.stl, DRV8829PWP.stp, EDI2CAP.CFG, ESP32-WROOM-32__16MB_.stl, ESP32-WROOM-32__16MB_.stp, FT232RL.stl, FT232RL.stp]
2021-04-13 currently implementing the imu and math vector and orientation
2021-04-14 added quaternions and some vector math utils
    [configuration.h]
2021-04-16 started to code the communication with the EspCam. Also some better code separation between the EspCam and tank Alpha. Some more additions to the code and some reformatting and bug fixes
    [BdcMotor.cpp, CameraSensor.h, FunctioningMode.cpp, FunctioningMode.h]
2021-04-16 currently working on esp-cam and Alpha
2021-04-18 finished all drivers except rf (needs thorough testing)
2021-04-18 found problematic I2C communication in slave espcam device. currently implementing my own I2C slave lib
    [CameraSensor.h, TankAlpha.cpp, TankAlpha.h, WiFiServerHydra.cpp, WiFiServerHydra.h]
2021-04-20 Custom I2C protocol is AFHUAIHFDJKSAFJ done.
    [configuration.h]
2021-04-20 added some test classes for I2C stretching. I'm currently investigating to implement clock stretching
2021-04-21 stretching doesn't work because of the implementation I started with
    [SlowMasterI2c.cpp, SlowMasterI2c.h, SlowSlaveI2c.cpp, SlowSlaveI2c.h]
2021-04-21 pushing in case I want to pass more time to try to make the custom I2C port work
2021-04-21 added the findRotator function for future triangulation. Slow I2C worls ok, and it's implemented with the rest of the code
2021-04-22 currently testing the sonar. It can't be tested straight like that on the Esp32, we need a voltage converter.
2021-04-23 finished to implement all the features (excepted RF, but that's comming along nicely). I'm at a point where I need to test everything from bottom up. I can also start to implement harder or more comp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
2021-04-23 color detection algorithm is done and implemented. Fixed bad pixel position calculation
    [CameraSensor.cpp, CameraSensor.h]
2021-04-24 Merged RF communication code. Everything is compiling. We still need to add the feedback control with the imu, but that's about whats left before we are done
2021-04-24 adjusted the data conversion for the servos and throttle/steer
2021-04-24 added smoothing for the servos and micro-torquing for the bdcs
2021-04-28 xra1201 driver and servo driver works
2021-04-30 fixed bdc motors. Calibration of servos is almost done
    [BdcMotor.cpp, BdcMotor.h, Outputs.cpp]
2021-04-30 battery sensor works
2021-05-01 added call to update and start of timer
2021-05-03 sonar querries work. Bno055 yaw works. Currently implementing the sonar scanner
2021-05-05 currently debugging the WiFi
2021-05-05 wifi working on it
    [brushed_motor_drivers.SchDoc, servo_driver_and_imu_device.SchDoc]
2021-05-06 added trimmed down cam project folder for JS. Camera color detection, face detection and send over wifi now works like a charm
2021-05-10 WiFi hfshfkhsfjk reconnects after connection loss without reseting the esp32, so cool
    [CameraSensor.cpp, DataConverter.cpp, EspCam.cpp, ListeningToYourCommands.cpp, OutgoingCommunicationFormat.h]
2021-05-10 fixed a bug with serial
    [EspCam.cpp]
2021-05-17 fixed bugs related to rf
    [BdcMotor.cpp, DataConverter.cpp, FunctioningMode.cpp, IncommingCommunicationFormat.h, Main.java, RfLessControlTest.cpp, SonarScanner.cpp]
2021-05-23 fixed color detection and java displayer
    [CameraSensor.cpp, Main.java]
